jordibinefa/IoT-02/codes/wifi_mqtts_snap/IoT-02_mqtts_05_subButtonsPubOutputs.png

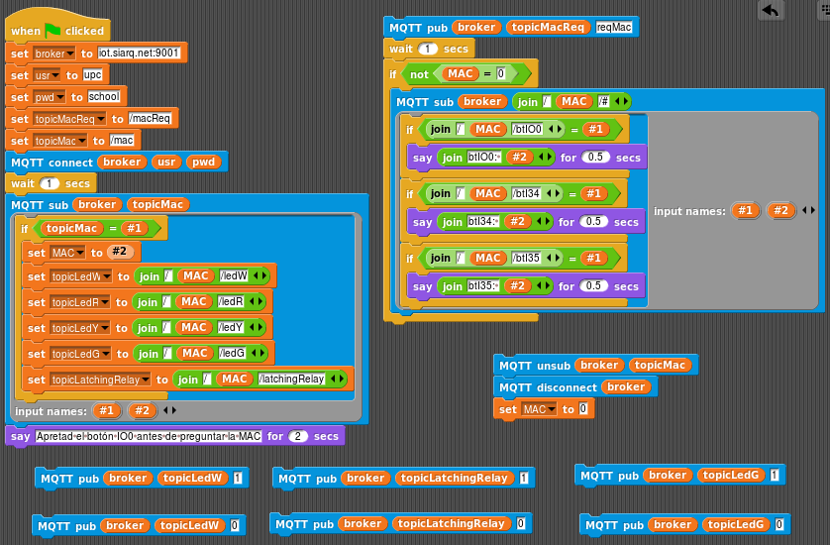
codes/wifi_mqtts_snap/IoT-02_mqtts_05_subButtonsPubOutputs.png
