jordibinefa/IoT-02/codes/wifi_mqtts_snap/IoT-02_mqtts_08_requestingTemperature.png

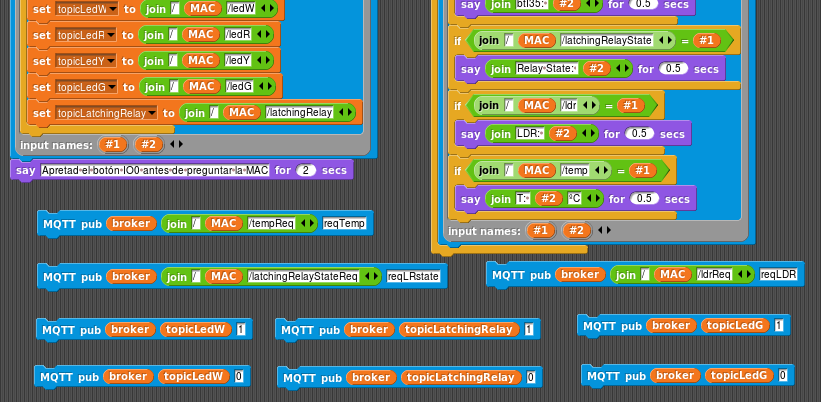
codes/wifi_mqtts_snap/IoT-02_mqtts_08_requestingTemperature.png
