jordibinefa/IoT-02/README.md

# IoT-02
Codes and schematics of IoT-02 board
