jordibinefa/IoT-02/iot02_00_en.pdf

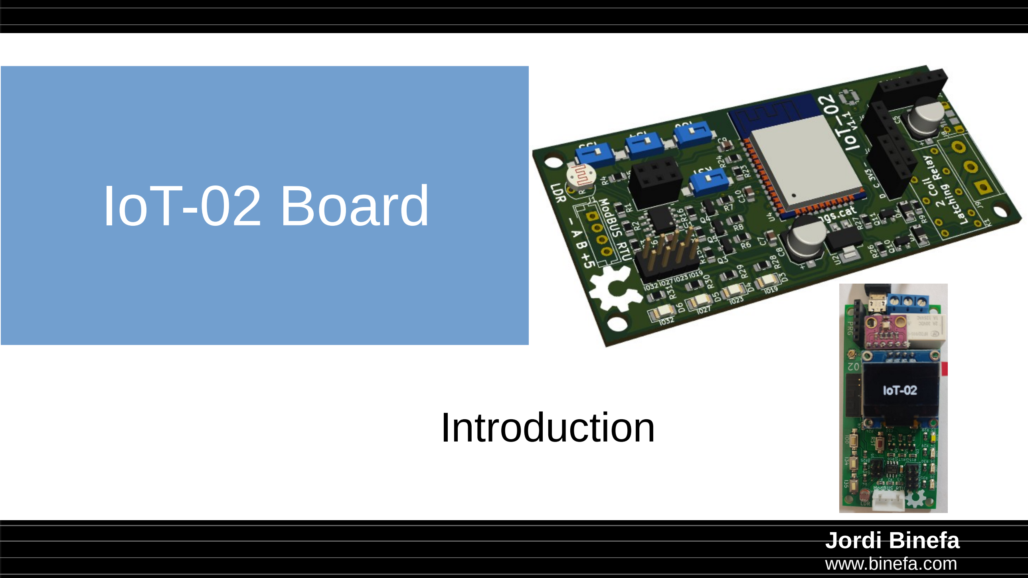
[picture p3: page 1]

## IoT-02 Board

Introduction

Jordi Binefa
www.binefa.com

IoT-02 Board ● Project repository ● Electronic schematic ● Key components ● Arduino IDE settings ● Firmware programming

www.binefa.com

## IoT-02 Board

- Project repository:
https://github.com/jordibinefa/IoT-02

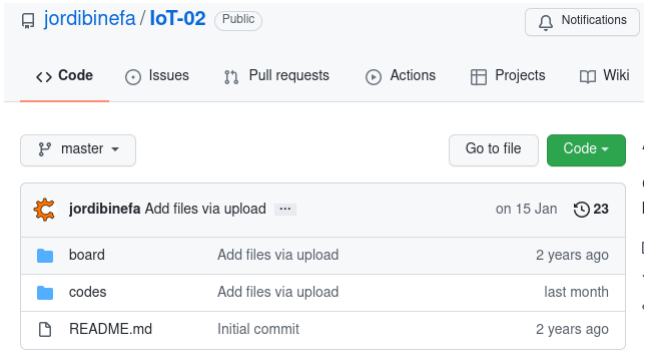
[picture p4: figure]

www.binefa.com

## IoT-02 Board

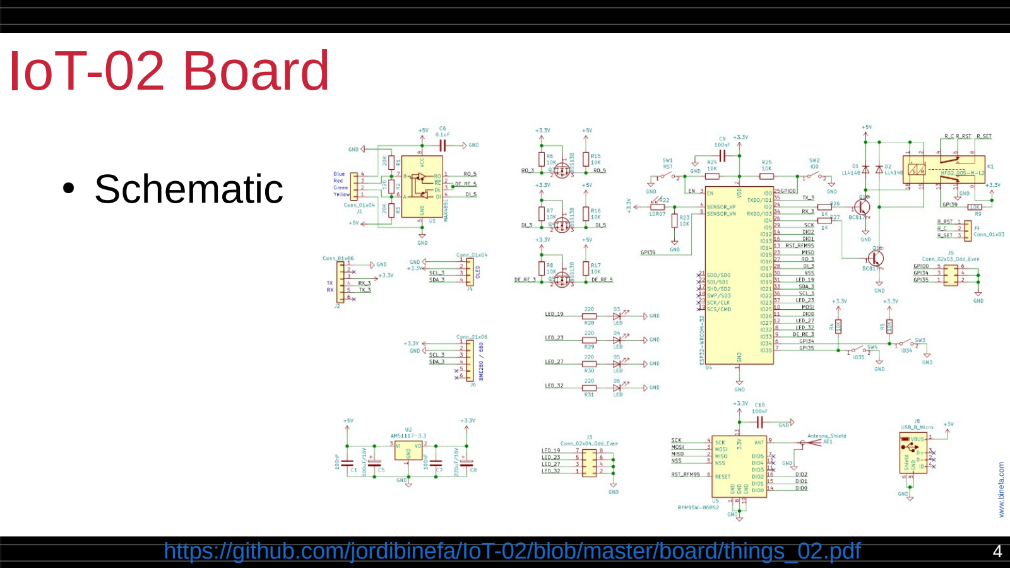
[picture p5: page 4]

- Schematic

https://github.com/jordibinefa/IoT-02/blob/master/board/things_02.pdf

www.binefa.com

IoT-02 Board ● CPU (ESP32) ● LDR ● Buttons ● Latching Relay

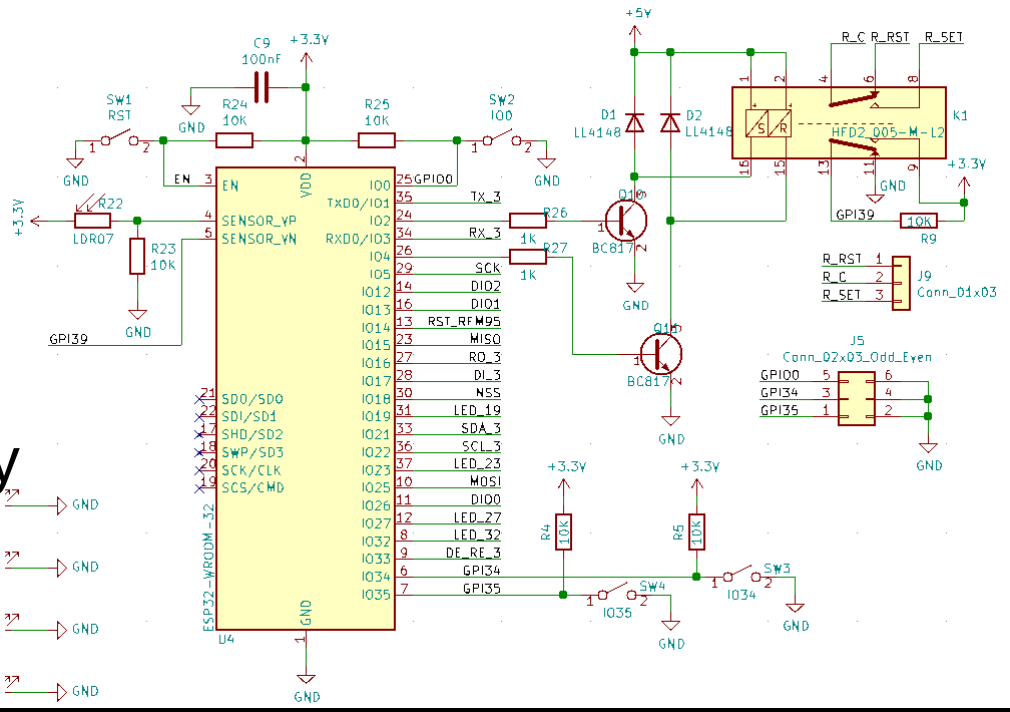
[picture p6: figure]

www.binefa.com

## IoT-02 Board

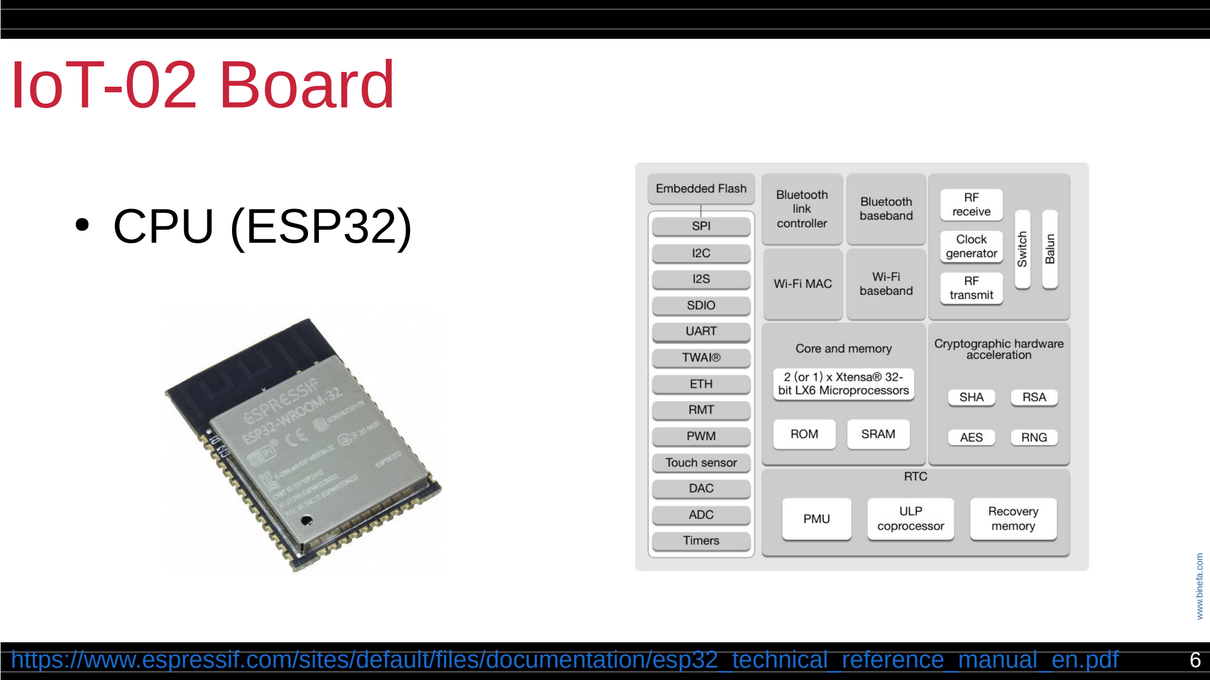
[picture p7: page 6]

- CPU (ESP32)

https://www.espressif.com/sites/default/files/documentation/esp32_technical_reference_manual_en.pdf

www.binefa.com

## IoT-02 Board

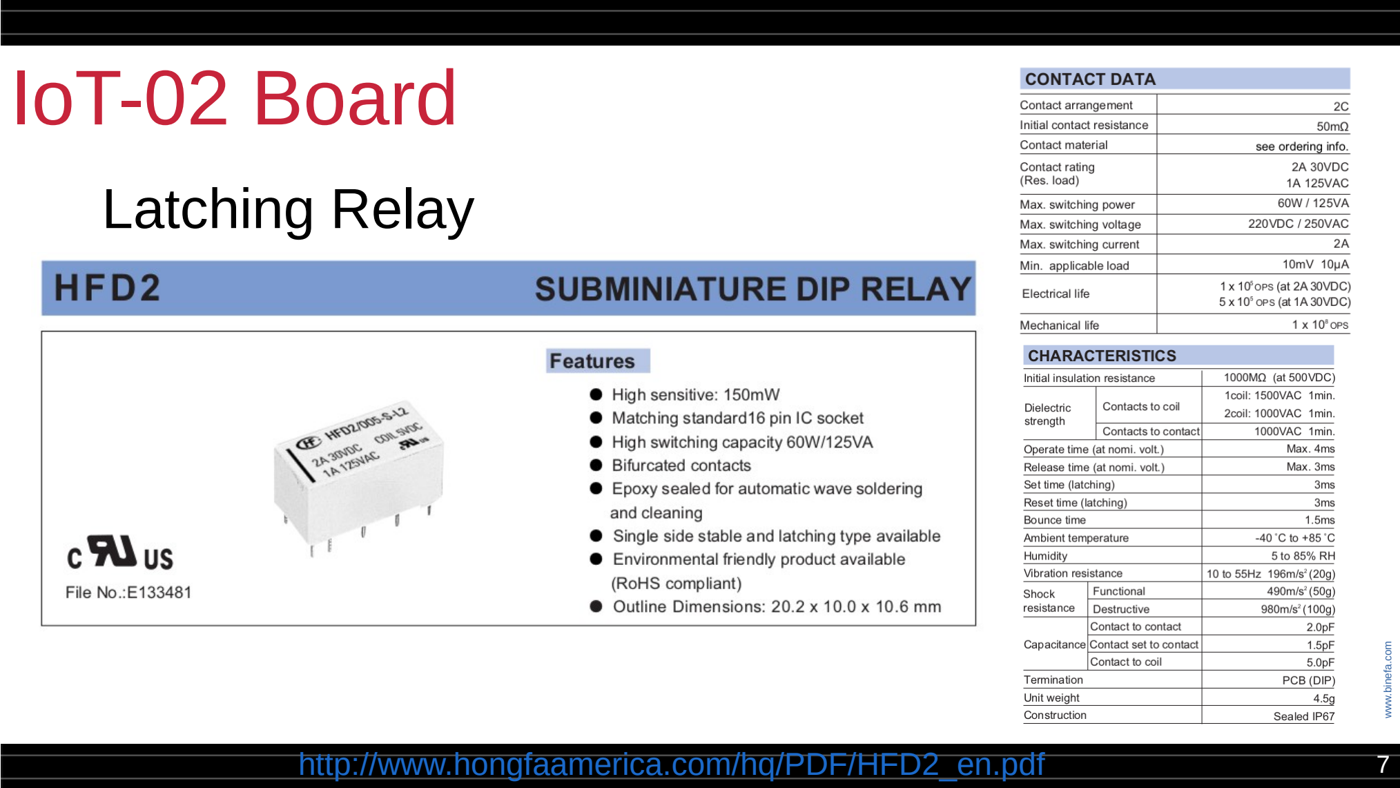
[picture p8: page 7]

Latching Relay

http://www.hongfaamerica.com/hq/PDF/HFD2_en.pdf

www.binefa.com

## IoT-02 Board

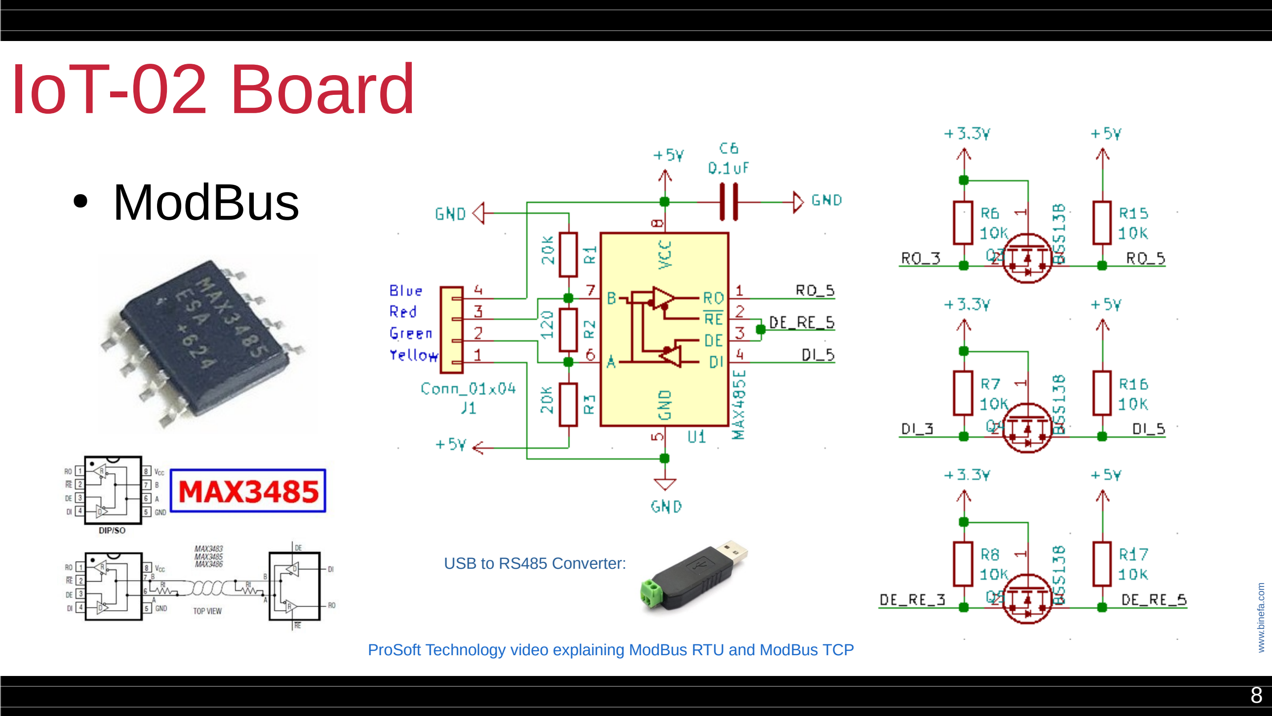
[picture p9: page 8]

- ModBus
ProSoft Technology video explaining ModBus RTU and ModBus TCP (https://youtu.be/k993tAFRLSE) | www.binefa.com

USB to RS485 Converter: (https://www.aliexpress.com/item/1005003395593541.html)

## IoT-02 Board

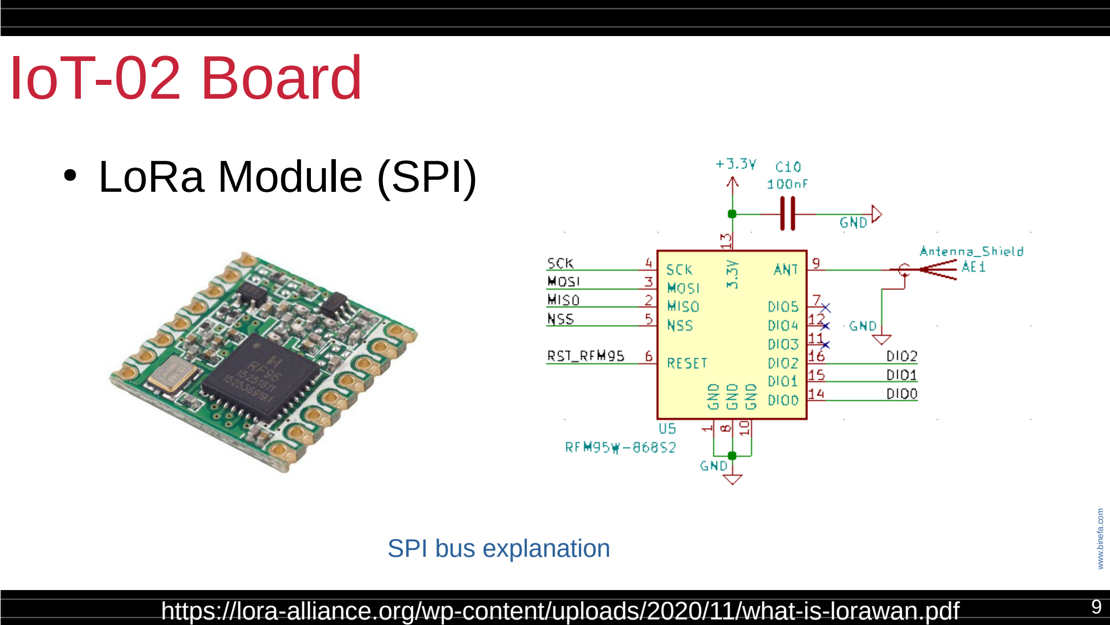
[picture p10: page 9]

- LoRa Module (SPI)

https://lora-alliance.org/wp-content/uploads/2020/11/what-is-lorawan.pdf

www.binefa.com
SPI bus explanation (https://www.luisllamas.es/arduino-spi/)

## IoT-02 Board

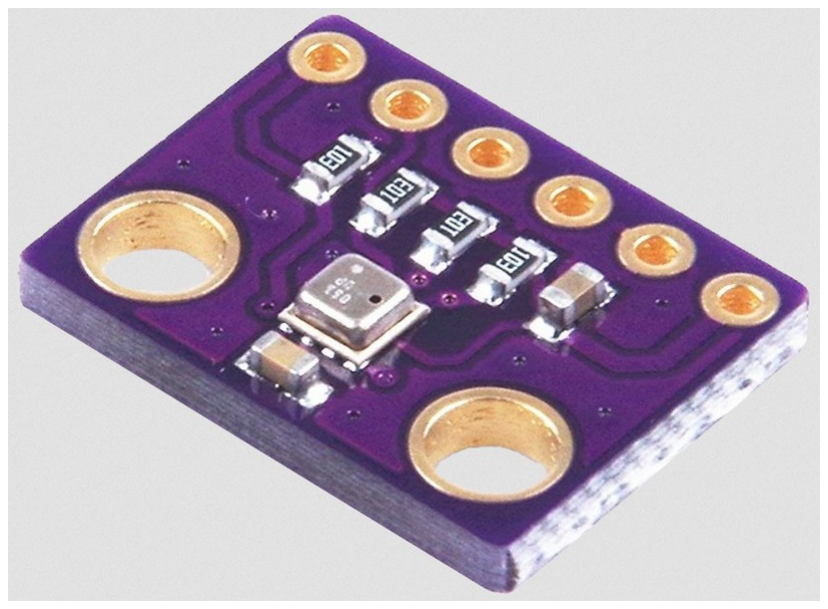
[picture p11: figure]

- I2C (BME280)

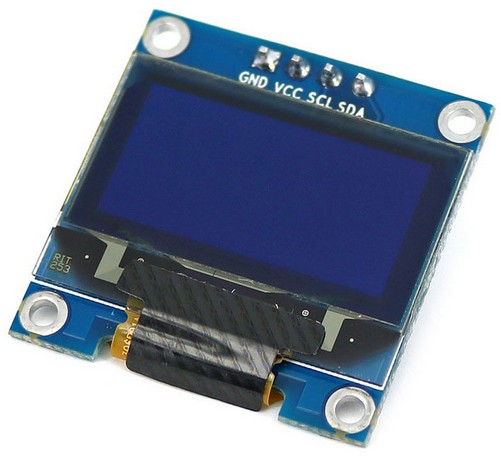
[picture p12: figure]

- I2C (OLED 0.96’’)

www.binefa.com
I2C bus explanation (https://www.luisllamas.es/arduino-i2c/)

## IoT-02 Board

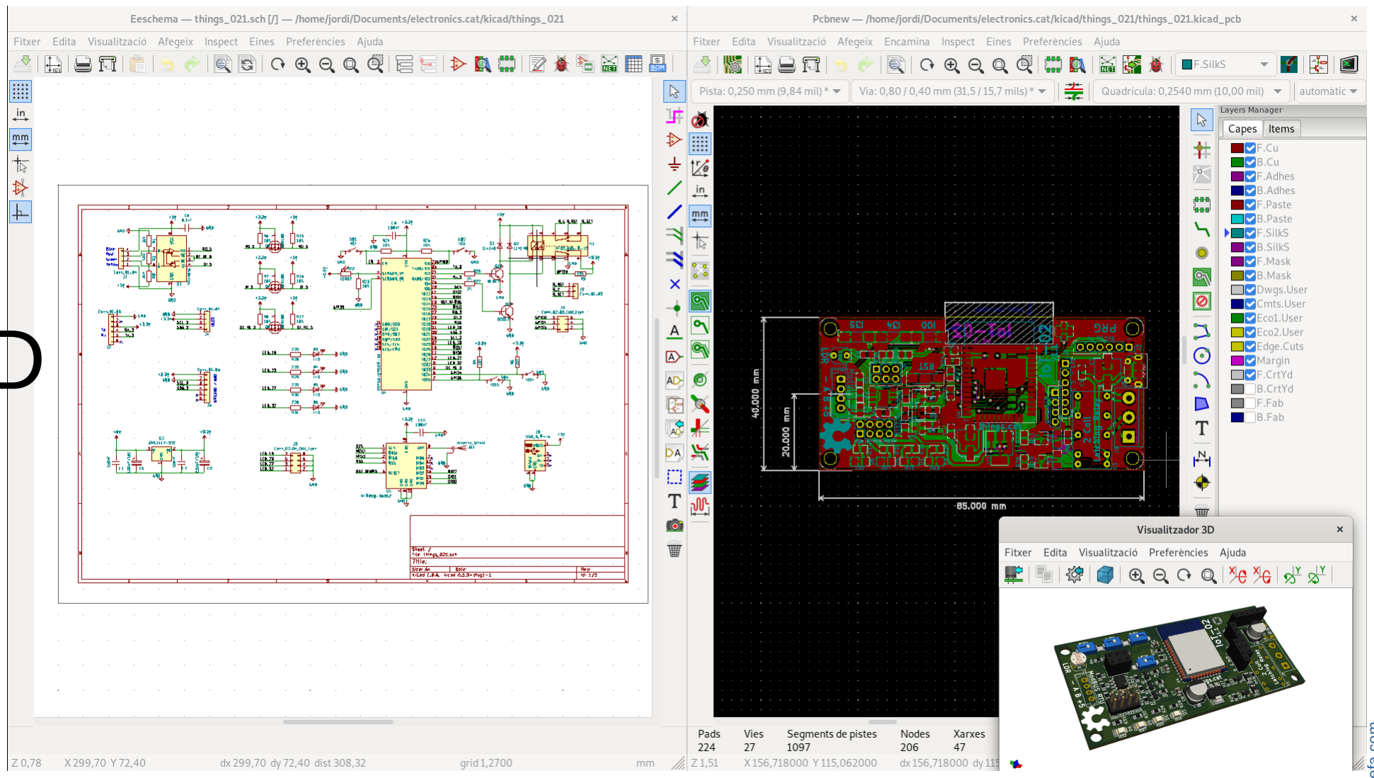
[picture p13: figure]

- Made with KiCAD

www.binefa.com

https://www.kicad.org/

## IoT-02 Board

Programmable with

- Arduino IDE
- Platform IO

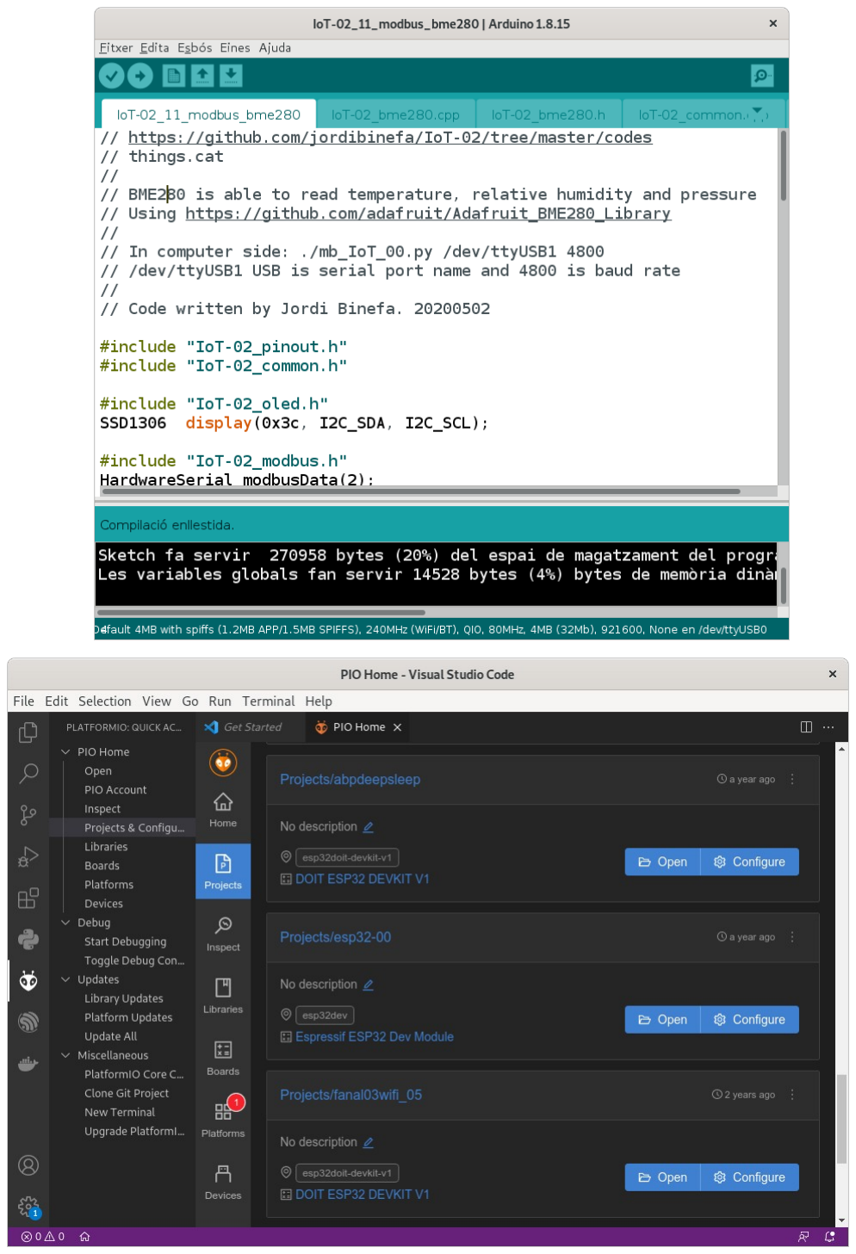
[picture p14: figure]

https://www.arduino.cc/ | https://platformio.org/

www.binefa.com

## IoT-02 Board

Installing ESP32 Add-on in Arduino IDE

www.binefa.com

- In your Arduino IDE, go to File / Preferences. Enter the following into the Additional Board Manager URLs :

https://dl.espressif.com/dl/package_esp32_index.json

- Open the Boards Manager. Go to Tools / Board: "..." / Boards Manager ... Search for ESP32 and press install button for the ESP32 by Espressif Systems . Approximately 300MB are automatically downloaded.
- Once it is installed, close the board installation popup. Select Tools / Board: "..." / ESP32 Dev Module. Select the Port at Tools / Port / /dev/ttyUSB0 (in Windows the port is COMx)

## IoT-02 Board

Arduino IDE libraries (493MB) (http://rebost.binefa.cat/iot/arduino/libraries_20220219.zip)

- These libraries are for compiling code examples (https://github.com/jordibinefa/IoT-02/tree/master/codes)

www.binefa.com

http://rebost.binefa.cat/iot/arduino/

Download all GitHub codes (https://github.com/jordibinefa/IoT-02/archive/refs/heads/master.zip) and Arduino IDE libraries (http://rebost.binefa.cat/iot/arduino/libraries_20220219.zip) on your computer. Libraries must be placed in the libraries directory inside Arduino folder ( /home/user in GNU / Linux and My Documents in Windows)

## IoT-02 Board

Sequence to select programming mode on IoT-02 board:

- Press the red button (RST)
- Press the IO0 white button
- Stop pressing the red button (RST)
- Stop pressing the IO0 white button

www.binefa.com

## IoT-02 Board

Uploading example firmware

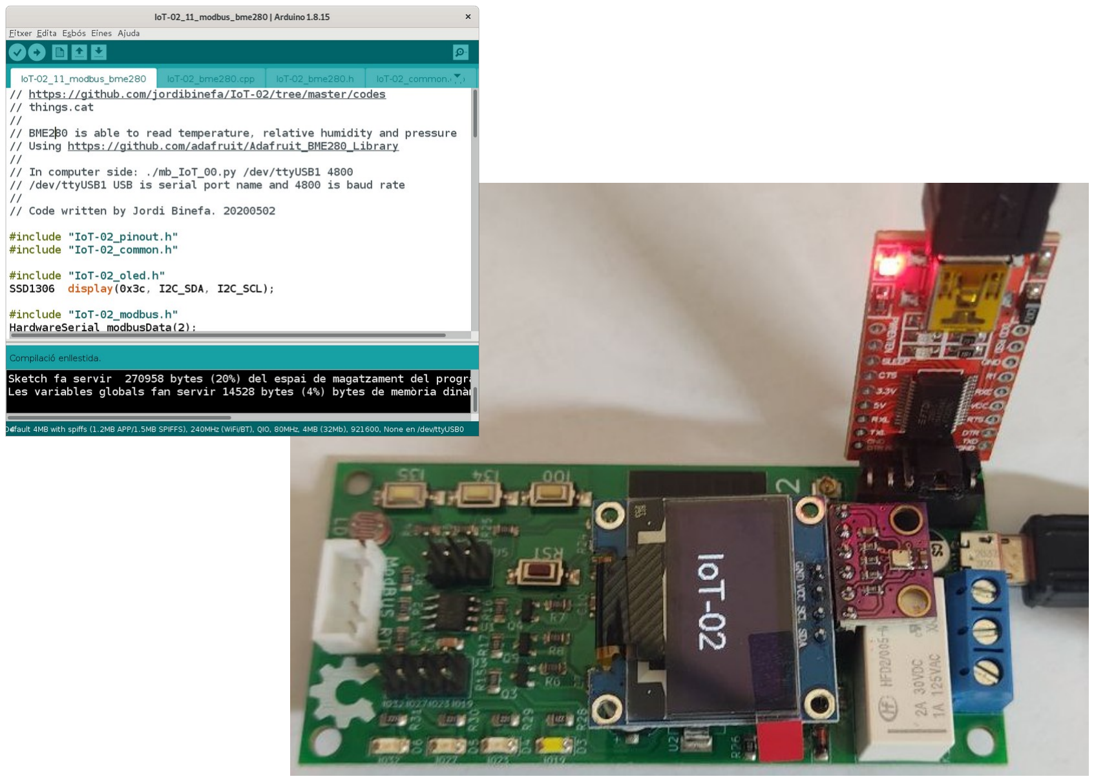
[picture p15: figure]

www.binefa.com

From Arduino IDE, open
IoT-02_07_SSD1306_BME280.ino (https://github.com/jordibinefa/IoT-02/tree/master/codes/IoT-02_07_SSD1306_BME280) file, previously downloaded with other example codes.

Set IoT-02 board in programming mode, connect the red board, and upload the firmware by pressing the round button with right pointing arrow ( )

## IoT-02 Board

Physical connection with other devices

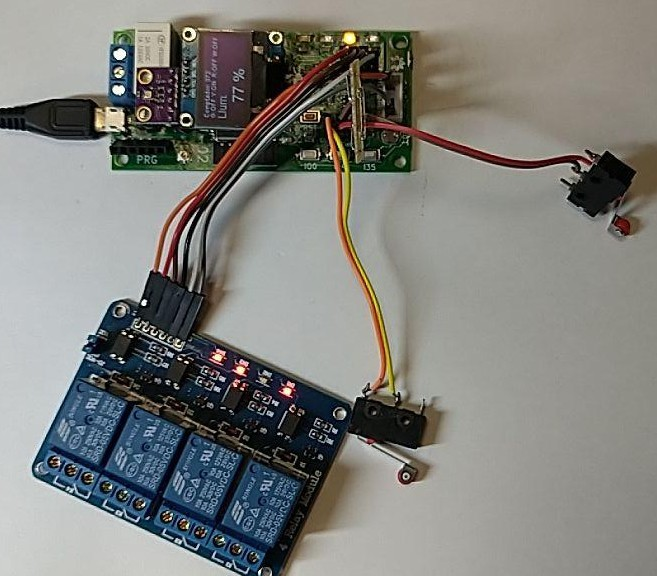
[picture p16: figure]

www.binefa.com

## IoT-02 Board

Practical Demonstration

www.binefa.com

## IoT-02 Board

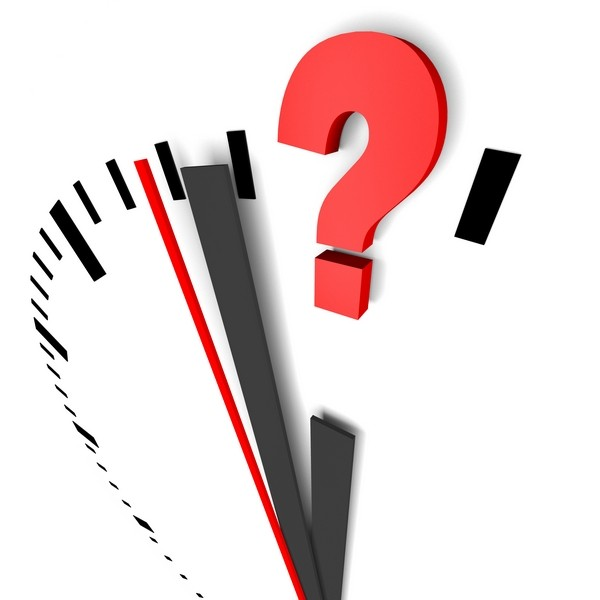
[picture p17: figure]

Question Time

www.binefa.com
