jordibinefa/IoT-02/iot02_00_ca.pdf

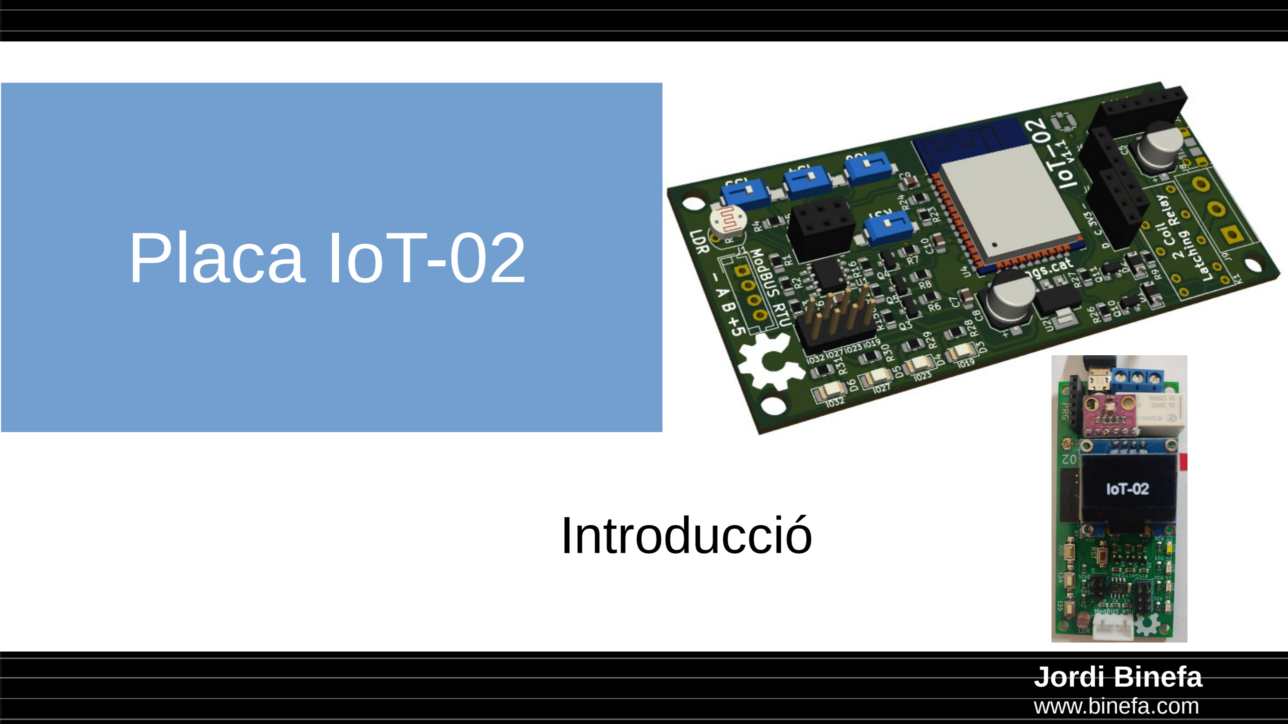
[picture p18: page 1]

# Placa IoT-02

# Introducció

Jordi Binefa
www.binefa.com

# Placa IoT-02

# - Repositori del projecte - Esquema electrònic - Components clau - Configuració de l’IDE d’Arduino - Programació del microprogramari

www.binefa.com

# Placa IoT-02

# - Repositori del projecte: https://github.com/jordibinefa/IoT-02


www.binefa.com

# Placa IoT-02

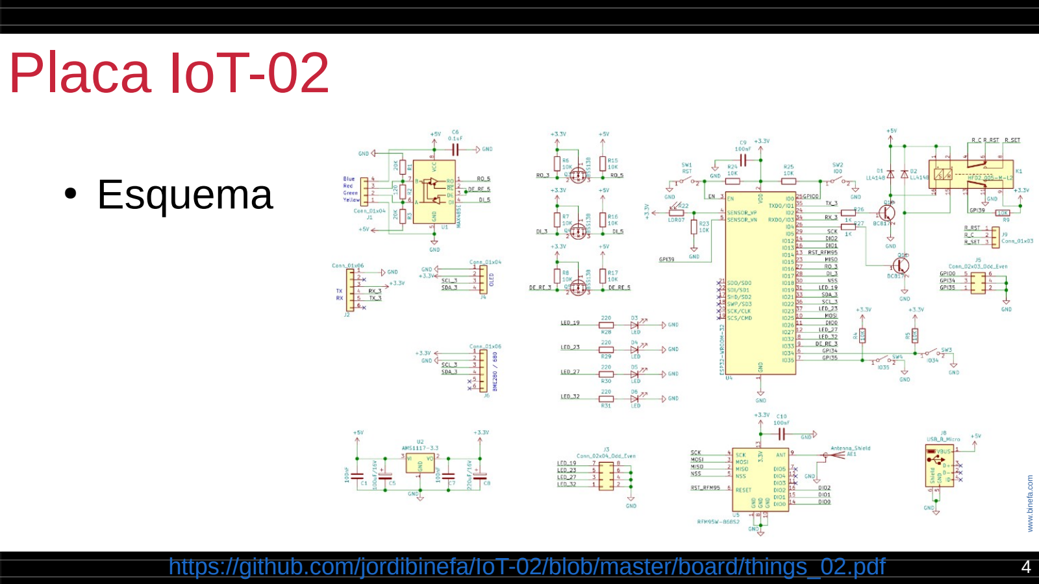
[picture p19: page 4]

# - Esquema

https://github.com/jordibinefa/IoT-02/blob/master/board/things_02.pdf

www.binefa.com

# Placa IoT-02 ● CPU (ESP32) ● LDR ● Botons ● Relé biestable

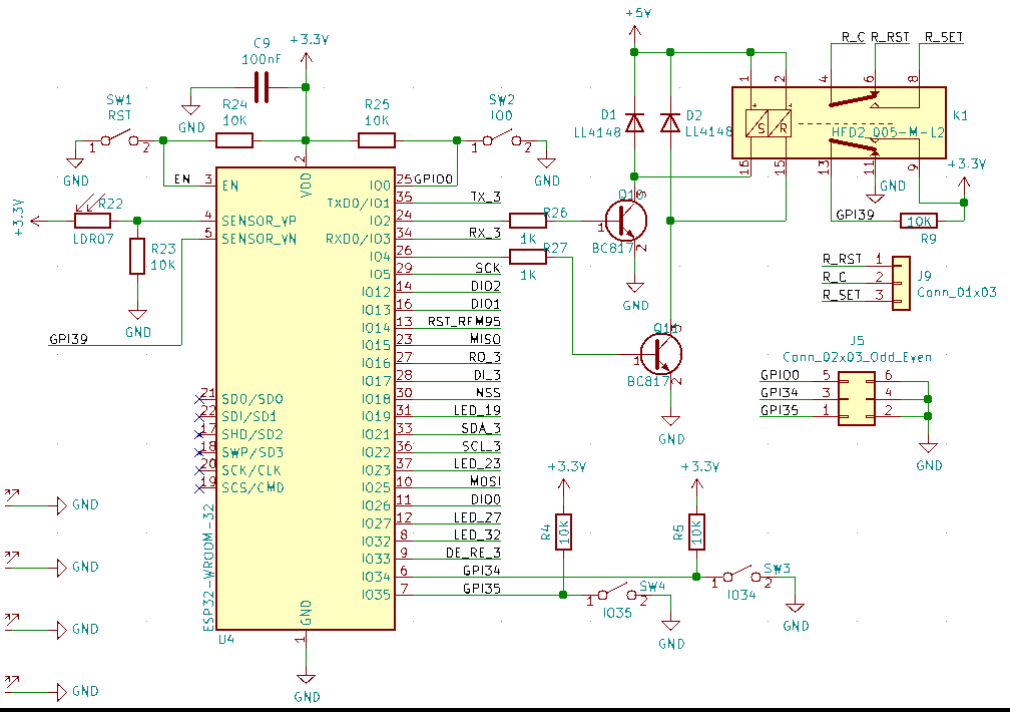
[picture p20: figure]

www.binefa.com

# Placa IoT-02

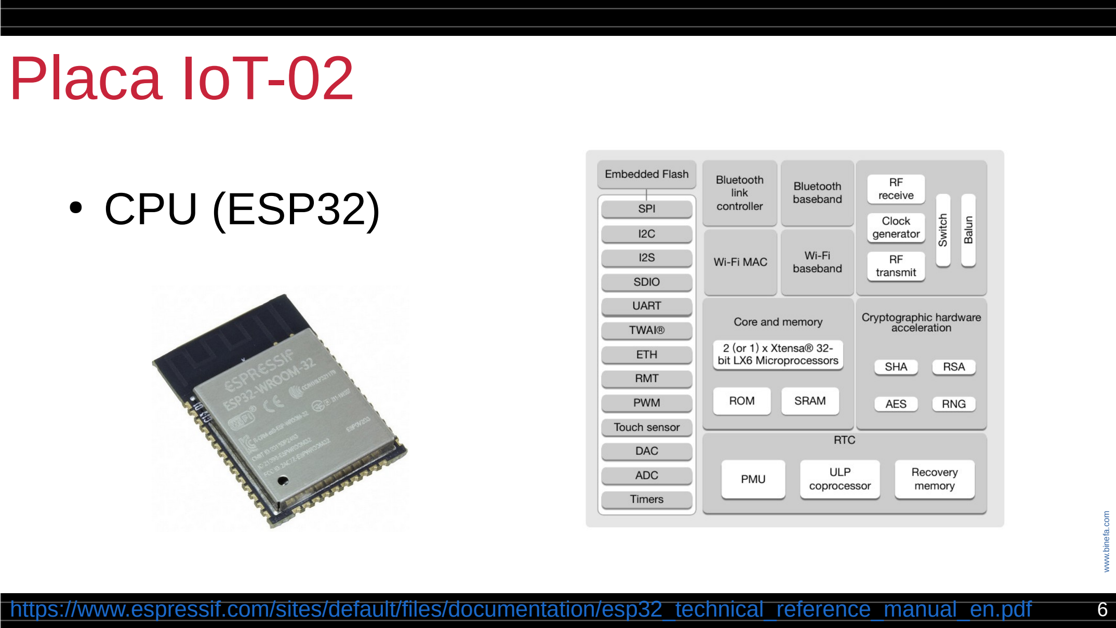
[picture p21: page 6]

# - CPU (ESP32)

https://www.espressif.com/sites/default/files/documentation/esp32_technical_reference_manual_en.pdf

www.binefa.com

# Placa IoT-02

# Relé biestable

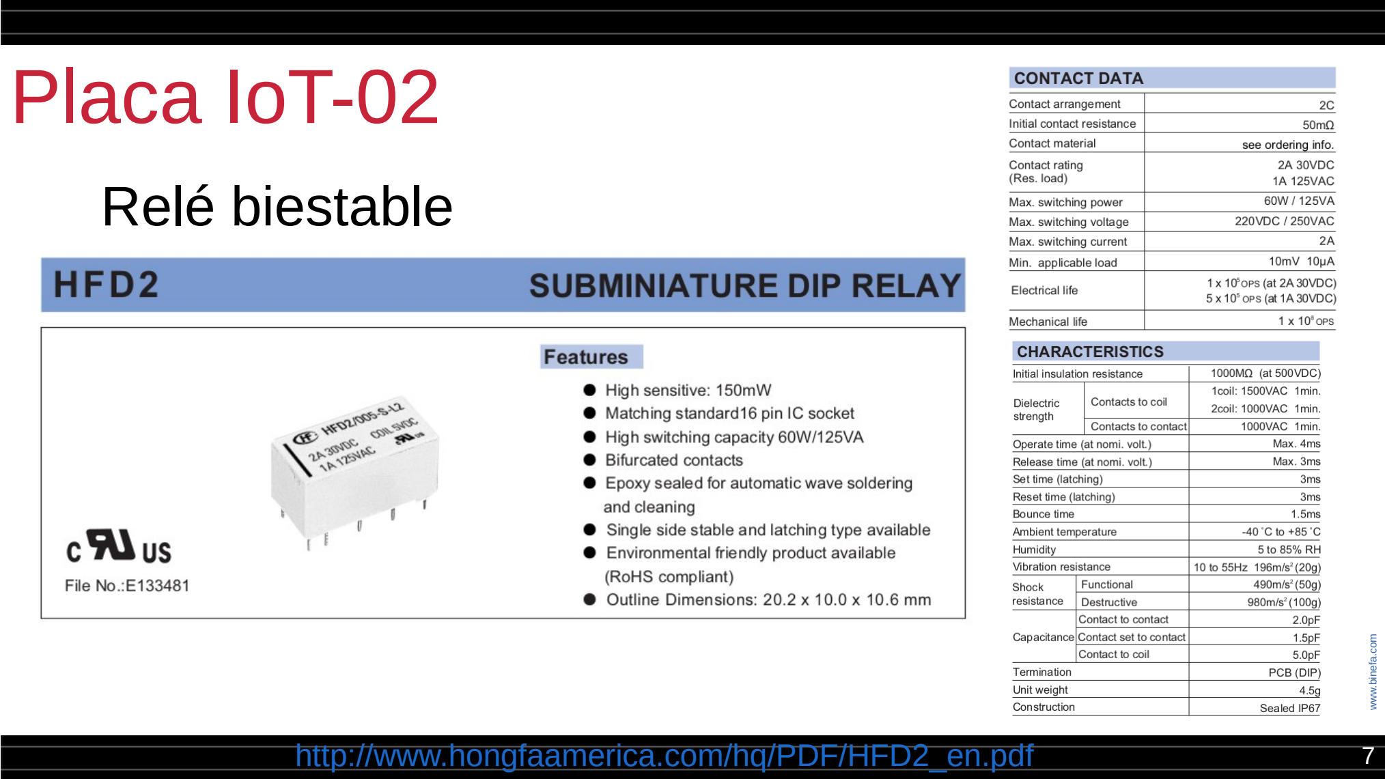
[picture p22: page 7]

http://www.hongfaamerica.com/hq/PDF/HFD2_en.pdf

www.binefa.com

# Placa IoT-02

# - ModBus

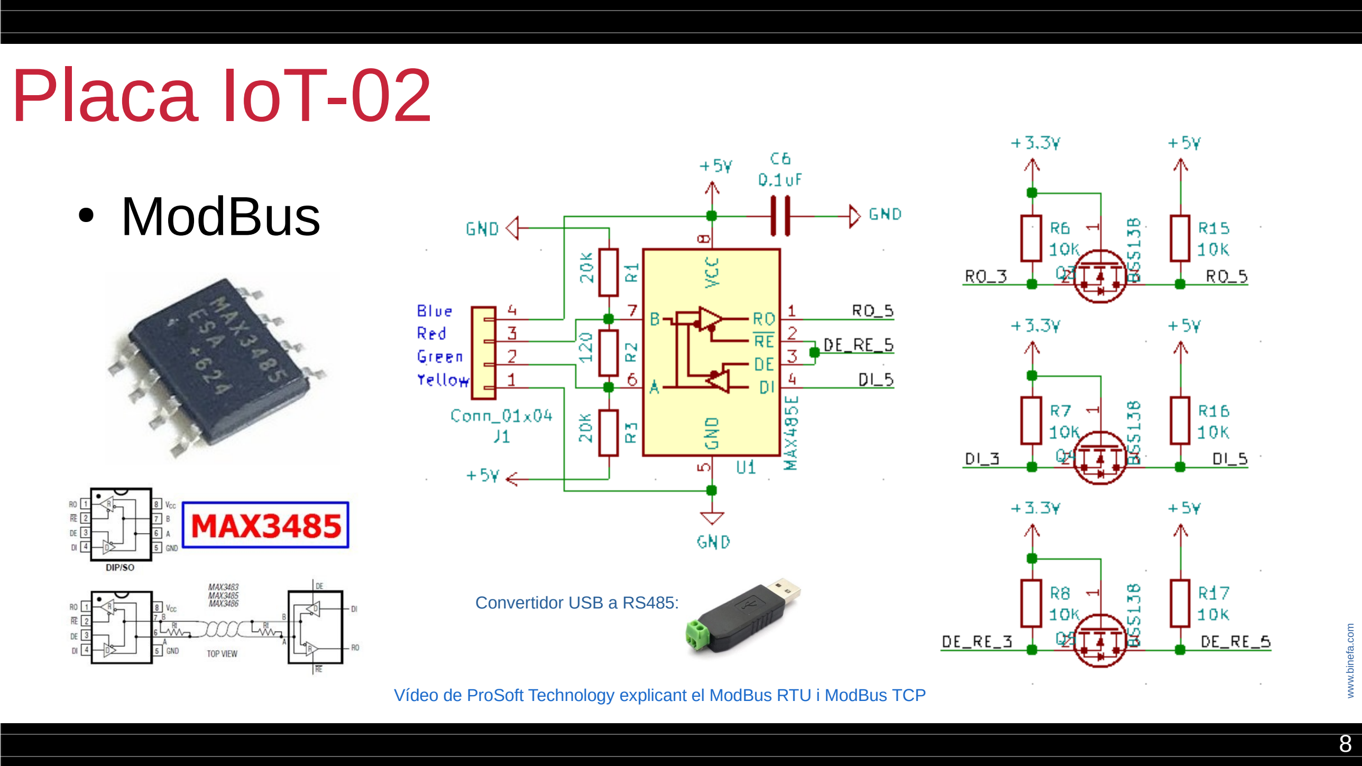
[picture p23: page 8]

Vídeo de ProSoft Technology explicant el ModBus RTU i ModBus TCP (https://youtu.be/k993tAFRLSE) | www.binefa.com

Convertidor USB a RS485: (https://www.aliexpress.com/item/1005003395593541.html)

# Placa IoT-02

# - Mòdul LoRa (SPI)

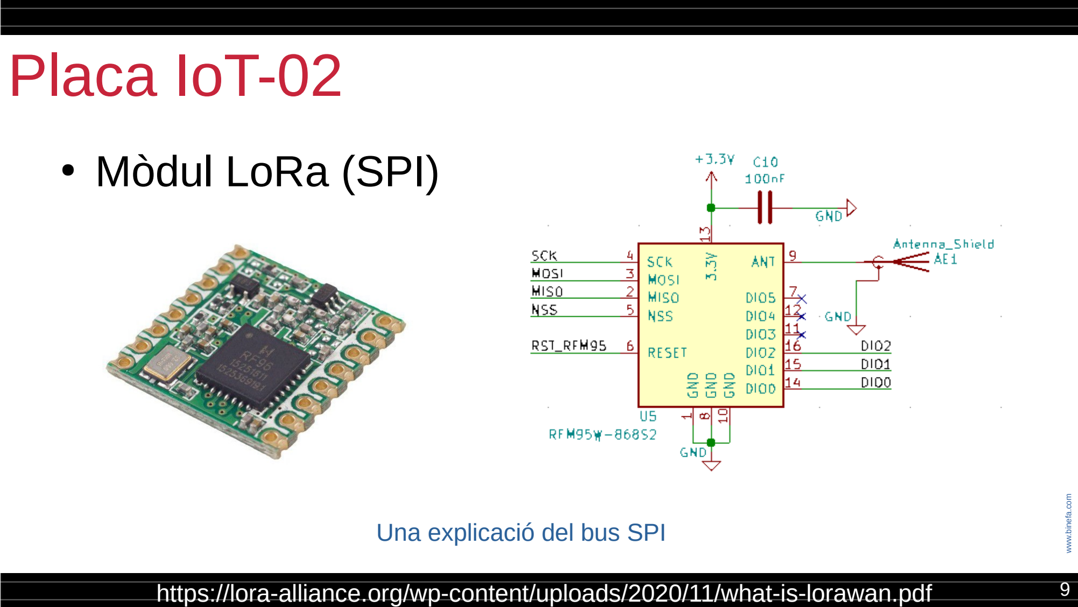
[picture p24: page 9]

https://lora-alliance.org/wp-content/uploads/2020/11/what-is-lorawan.pdf

www.binefa.com
Una explicació del bus SPI (https://www.luisllamas.es/arduino-spi/)

# Placa IoT-02


# - I2C (BME280)

# - I2C (OLED 0.96’’)

www.binefa.com

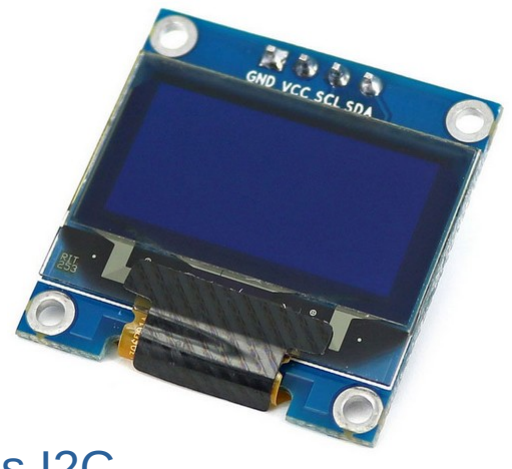
[picture p25: figure]

Una explicació del bus I2C (https://www.luisllamas.es/arduino-i2c/)

# Placa IoT-02

# - Fet amb KiCAD

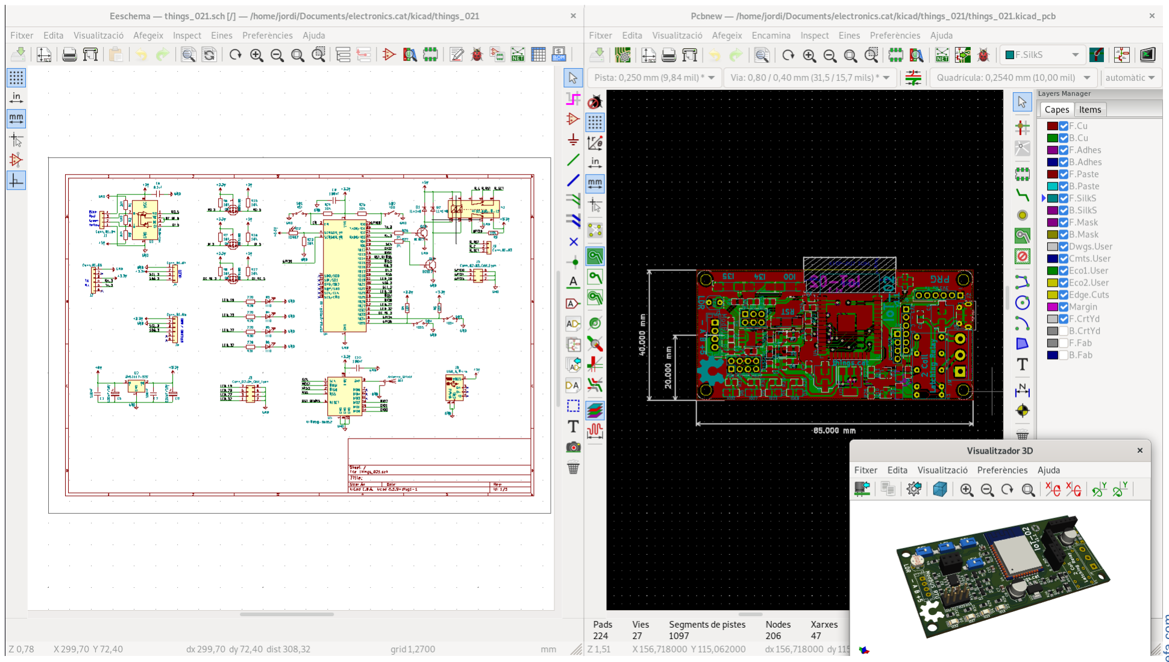
[picture p26: figure]

www.binefa.com

https://www.kicad.org/

# Placa IoT-02

# Programable amb

# - Arduino IDE

# - Platform IO


https://www.arduino.cc/ | https://platformio.org/

www.binefa.com

# Placa IoT-02

# Afegint l’ESP32 a l’IDE d’Arduino

www.binefa.com

- A l’IDE d’ Arduino aneu al menú i seleccioneu Fitxer / Preferències. Copieu a la casella indicada com URL addicionals del gestor de plaques :

https://dl.espressif.com/dl/package_esp32_index.json

- Al menú Eines / Placa: "..." / Gestor de plaques ... escriviu ESP32, seleccioneu esp32 by Espressif Systems i premeu el botó Instal·la. Aproximadament es baixen automàticament uns 300MB.
- Un cop instal·lat, tanqueu la finestra emergent de la instal·lació de la placa i seleccioneu Eines / Placa: "..." / ESP32 Dev Module. Després seleccioneu el port adient a Eines / Port / /dev/ttyUSB0 (a Windows el port és COMx)

# Placa IoT-02

Biblioteques per a l’Arduino IDE (493MB) (http://rebost.binefa.cat/iot/arduino/libraries_20220219.zip)

- Permeten compilar els exemples de codi (https://github.com/jordibinefa/IoT-02/tree/master/codes)

www.binefa.com

http://rebost.binefa.cat/iot/arduino/

Baixeu-vos al vostre ordinador tots els codis al GitHub (https://github.com/jordibinefa/IoT-02/archive/refs/heads/master.zip) i les biblioteques per a l’Arduino IDE. (http://rebost.binefa.cat/iot/arduino/libraries_20220219.zip) Les biblioteques les heu de posar al directori libraries que penja de la carpeta Arduino (present al directori base de l’usuari. /home/usuari a GNU / Linux i Els meus documents a Windows)

# Placa IoT-02

## Seqüència per passar a mode programació a la placa IoT-02:

## - Premeu el botó vermell (RST) - Premeu el botó blanc IO0 - Deixeu de prémer el botó vermell (RST) - Deixeu de prémer el botó blanc IO0

www.binefa.com

# Placa IoT-02

# Pujant un microprogramari d’exemple


www.binefa.com

Des de l’IDE d’Arduino obriu l’arxiu IoT-02_07_SSD1306_BME280.ino, (https://github.com/jordibinefa/IoT-02/tree/master/codes/IoT-02_07_SSD1306_BME280) baixat prèviament amb la resta de codis d’exemple.

Poseu la placa IoT-02 en mode programació, connecteu la placa vermella, i pugeu el microprogramari prement el botó rodó amb fletxa apuntant a la dreta ( )

# Placa IoT-02

# Connexió física amb altres dispositius


www.binefa.com

# Placa IoT-02

# Demostració pràctica

www.binefa.com

# Placa IoT-02

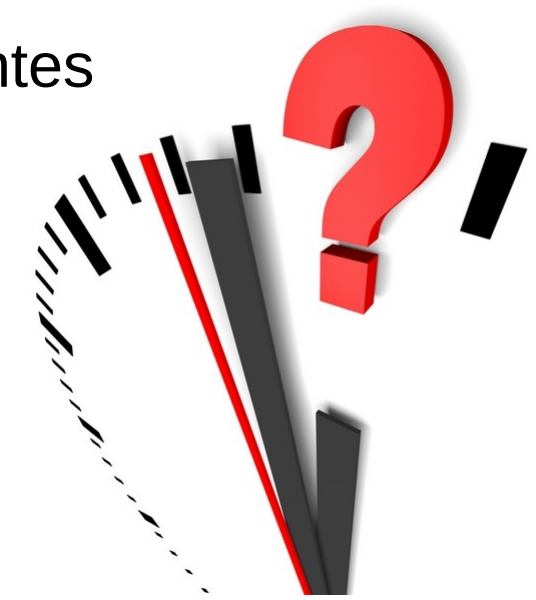
[picture p27: figure]

# Torn de preguntes

www.binefa.com
