jordibinefa/IoT-02/iot02_00_es.pdf

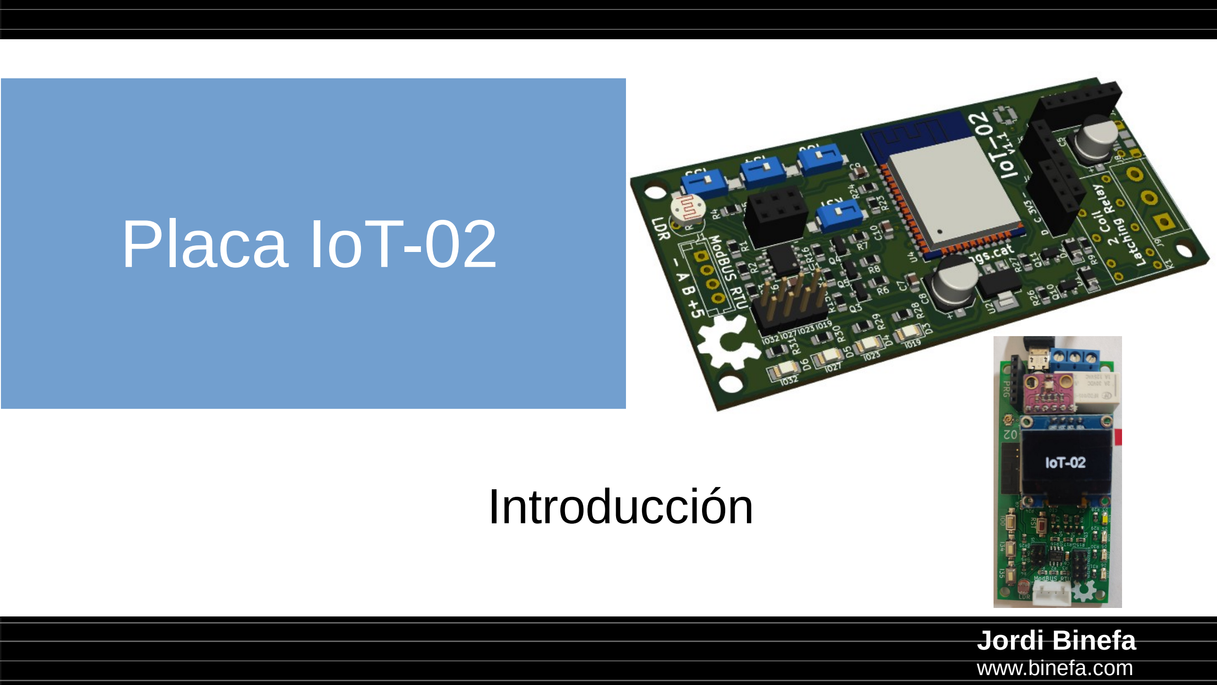
[picture p28: page 1]

# Placa IoT-02

# Introducción

Jordi Binefa
www.binefa.com

# Placa IoT-02

# - Repositorio del proyecto - Esquema electrónico - Components clave - Configuración del IDE de Arduino - Programación del firmware

www.binefa.com

# Placa IoT-02

# - Repositorio del proyecto: https://github.com/jordibinefa/IoT-02


www.binefa.com

# Placa IoT-02


# - Esquema

https://github.com/jordibinefa/IoT-02/blob/master/board/things_02.pdf

www.binefa.com

# Placa IoT-02 ● CPU (ESP32) ● LDR ● Botones ● Relé biestable


www.binefa.com

# Placa IoT-02


# - CPU (ESP32)

https://www.espressif.com/sites/default/files/documentation/esp32_technical_reference_manual_en.pdf

www.binefa.com

# Placa IoT-02

# Relé biestable


http://www.hongfaamerica.com/hq/PDF/HFD2_en.pdf

www.binefa.com

# Placa IoT-02

# - ModBus

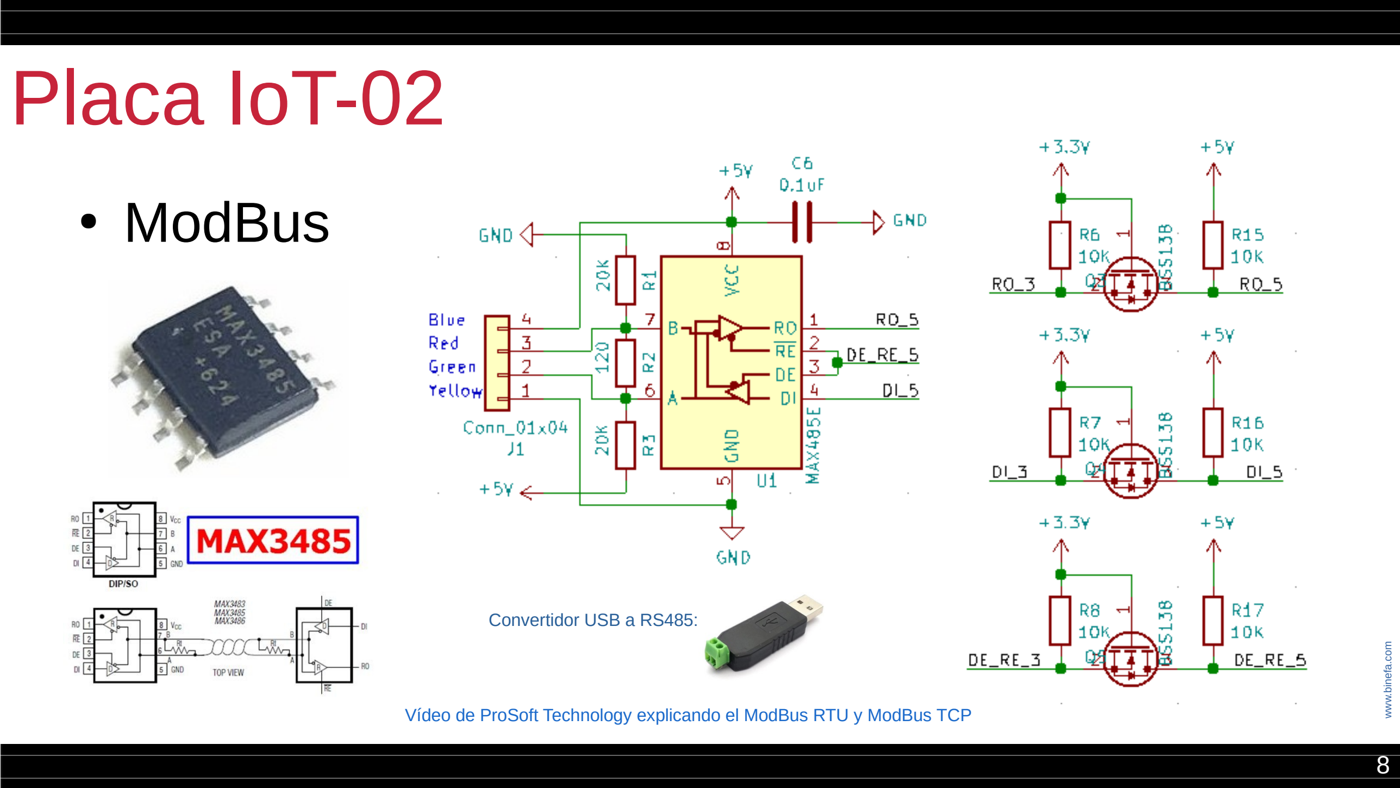
[picture p29: page 8]

Vídeo de ProSoft Technology explicando el ModBus RTU y ModBus TCP (https://youtu.be/k993tAFRLSE) | www.binefa.com

Convertidor USB a RS485: (https://www.aliexpress.com/item/1005003395593541.html)

# Placa IoT-02

# - Módulo LoRa (SPI)

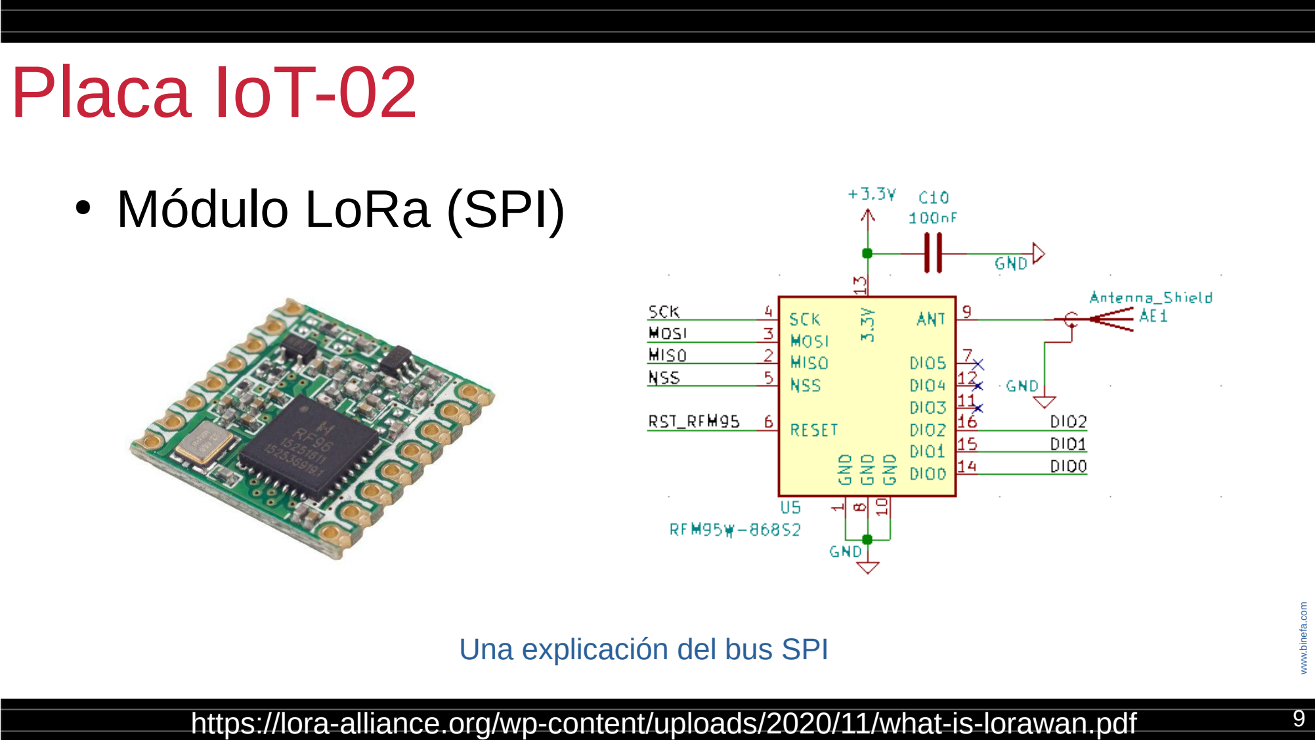
[picture p30: page 9]

https://lora-alliance.org/wp-content/uploads/2020/11/what-is-lorawan.pdf

www.binefa.com
Una explicación del bus SPI (https://www.luisllamas.es/arduino-spi/)

# Placa IoT-02


# - I2C (BME280)

# - I2C (OLED 0.96’’)

www.binefa.com

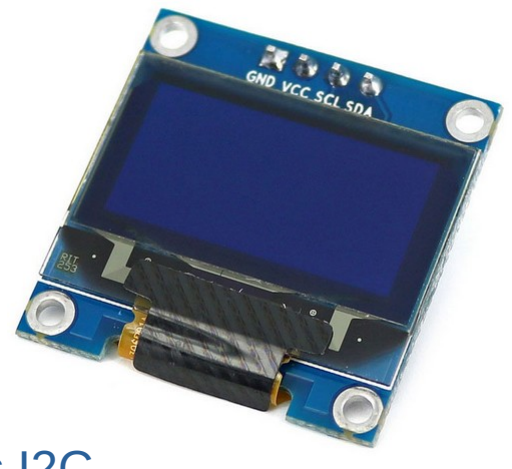
[picture p31: figure]

Una explicación del bus I2C (https://www.luisllamas.es/arduino-i2c/)

# Placa IoT-02

# - Hecho con KiCAD


www.binefa.com

https://www.kicad.org/

# Placa IoT-02

# Programable con

# - Arduino IDE

# - Platform IO


https://www.arduino.cc/ | https://platformio.org/

www.binefa.com

# Placa IoT-02

# Añadir ESP32 al IDE de Arduino

www.binefa.com

- En el IDE de Arduino ir al menú y seleccionar Fichero / Preferencias. Copiar en la casilla indicada como URLs adicionales del Gestor de placas:

https://dl.espressif.com/dl/package_esp32_index.json

- En el menú Herramientas / Placa: "..." / Gestor de placas escribir ESP32, seleccionar esp32 by Espressif Systems y clicar el botón Instalar. Aproximadamente se bajan automáticamente unos 300MB.
- Una vez instalado, cerrar la ventana emergente de instalación de la placa y seleccionar Herramientas / Placa: "..." / ESP32 Dev Module. Después seleccionar el puerto adecuado en Herramientas / Puerto / COMx (en GNU/Linux el puerto es /dev/ttyUSBx)

# Placa IoT-02

Bibliotecas para el IDE de Arduino (493MB) (http://rebost.binefa.cat/iot/arduino/libraries_20220219.zip)

- Permiten compilar los ejemplos de código (https://github.com/jordibinefa/IoT-02/tree/master/codes)

www.binefa.com

http://rebost.binefa.cat/iot/arduino/

Bajad al ordenador todos los códigos en el GitHub (https://github.com/jordibinefa/IoT-02/archive/refs/heads/master.zip) y las bibliotecas para el IDE de Arduino (http://rebost.binefa.cat/iot/arduino/libraries_20220219.zip) Las bibliotecas van al directorio libraries presente en la carpeta Arduino (que está en el directorio base del usuario. /home/usuario en GNU / Linux i Mis documentos en Windows)

●

# Placa IoT-02

## Secuencia para pasar a modo programación en la placa IoT-02:

## - Apretar el botón rojo (RST) - Apretar el botón blanco IO0 - Dejar de apretar el botón rojo (RST) - Dejar de apretar el botón blanco IO0

www.binefa.com

# Placa IoT-02

# Subiendo un firmware de ejemplo


www.binefa.com

Desde el IDE de Arduino abrid el archivo IoT-02_07_SSD1306_BME280.ino, (https://github.com/jordibinefa/IoT-02/tree/master/codes/IoT-02_07_SSD1306_BME280) bajado previamente con el resto de códigos de ejemplo.

Poned la placa IoT-02 en modo programación, conectad la placa roja, y subid el firmware apretando el botón redondo con flecha apuntando hacia la derecha ( )

# Placa IoT-02

# Conexión física con otros dispositivos


www.binefa.com

# Placa IoT-02

# Demostración práctica

www.binefa.com

# Placa IoT-02

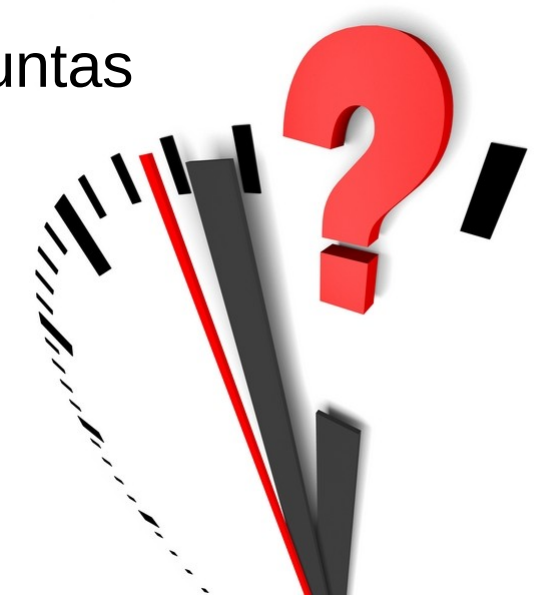
[picture p32: figure]

# Turno de preguntas

www.binefa.com
