jordibinefa/IoT-02/codes/binaryFirmware/IoT-02_Programmer.jpg

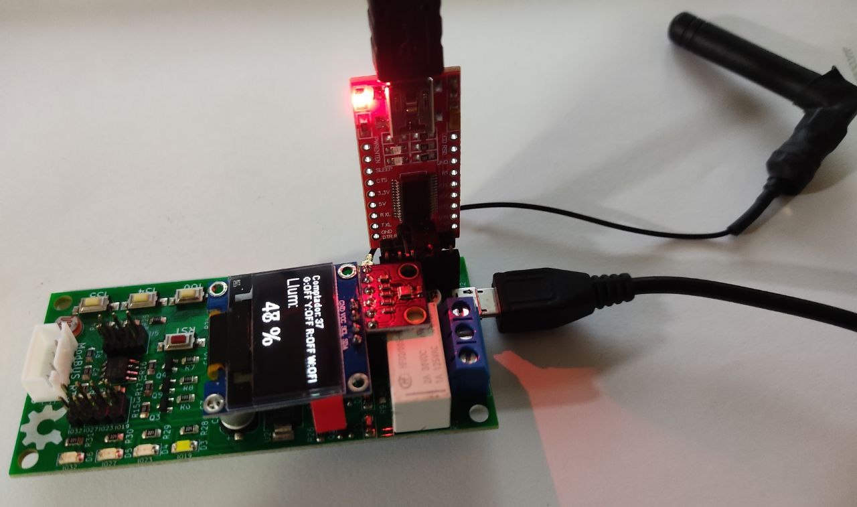
codes/binaryFirmware/IoT-02_Programmer.jpg
