jordibinefa/IoT-02/codes/binaryFirmware/Programming_IoT-02_screenshot.png

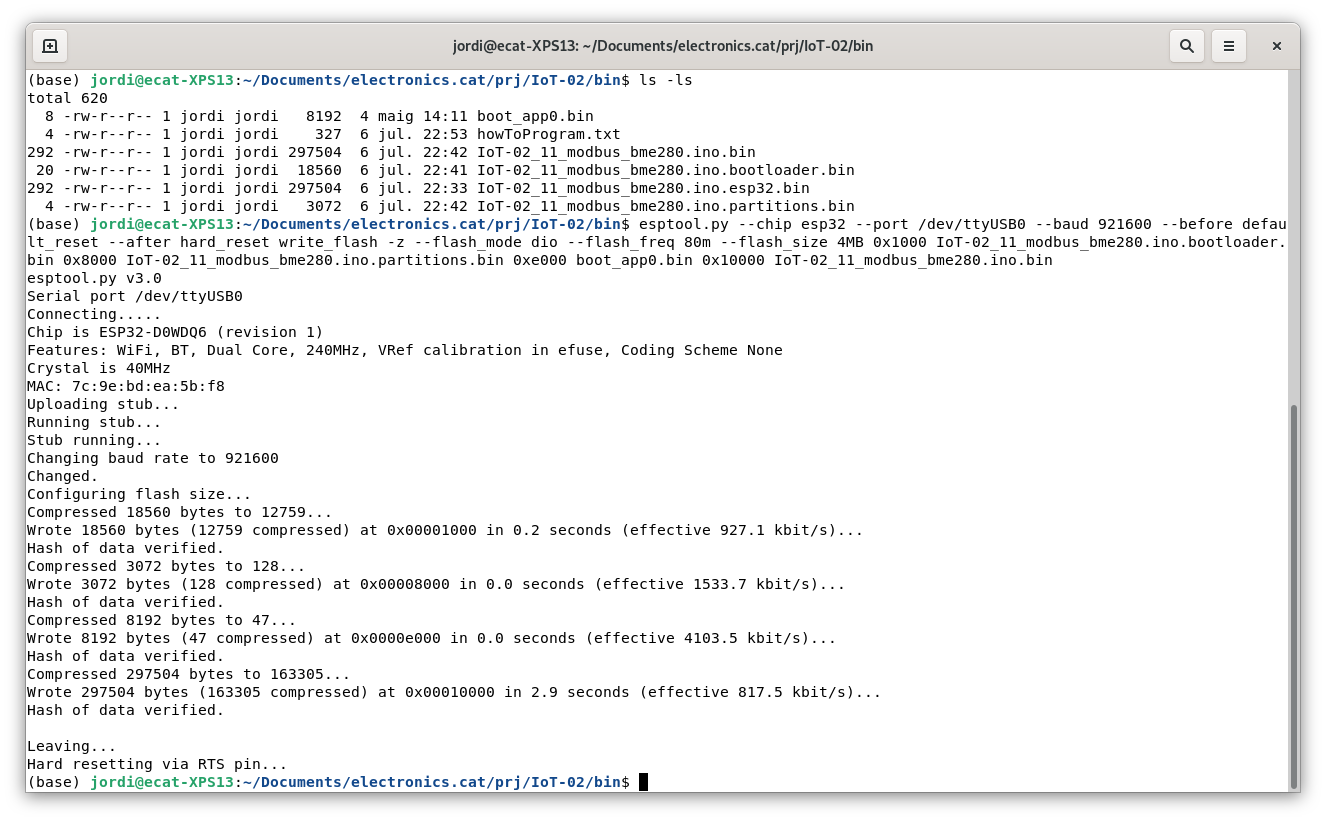
codes/binaryFirmware/Programming_IoT-02_screenshot.png
