jordibinefa/IoT-02/codes/wifi_basics/IoT-02_wifi_00_scan.png

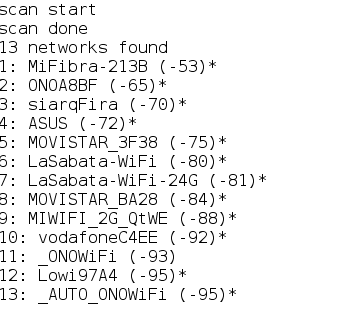
codes/wifi_basics/IoT-02_wifi_00_scan.png
