jordibinefa/IoT-02/codes/wifi_basics/IoT-02_wifi_03_multWiFi_wifiReset.png

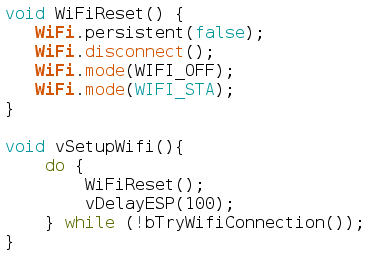
codes/wifi_basics/IoT-02_wifi_03_multWiFi_wifiReset.png
