jordibinefa/IoT-02/codes/wifi_mqtts_snap/IoT-02_mqtts_03_reqMac.png

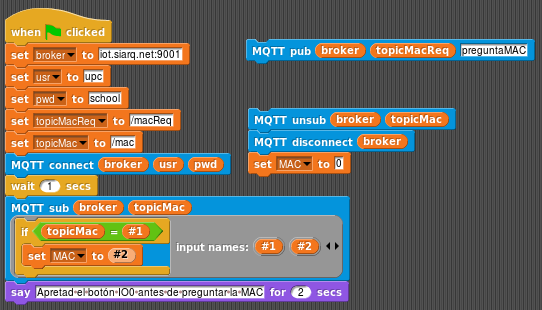
codes/wifi_mqtts_snap/IoT-02_mqtts_03_reqMac.png
