jordibinefa/IoT-02/codes/wifi_mqtts_snap/IoT-02_mqtts_04_ctrlOutputs.png

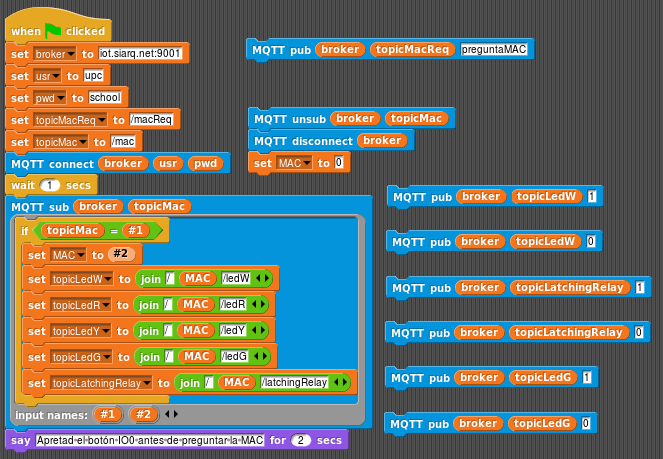
codes/wifi_mqtts_snap/IoT-02_mqtts_04_ctrlOutputs.png
