jordibinefa/IoT-02/codes/wifi_mqtts_snap/IoT-02_mqtts_06_requestingDigitalInput.png

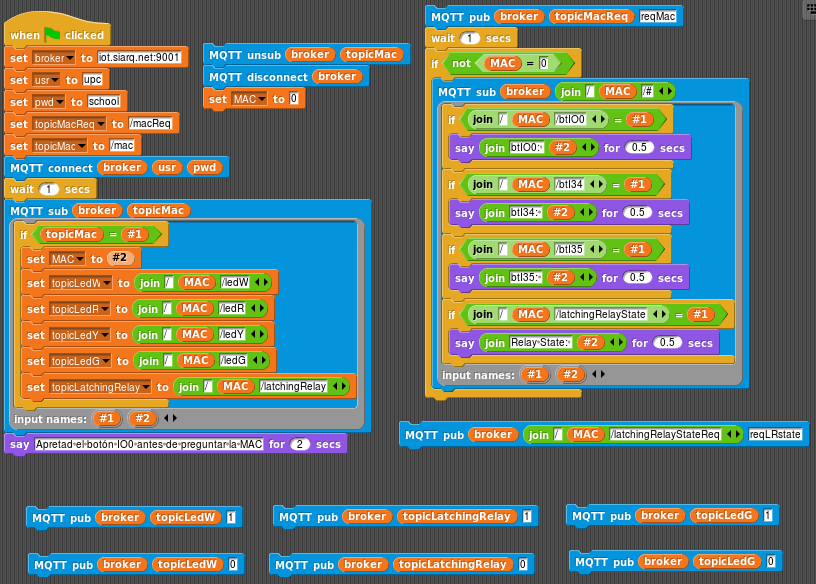
codes/wifi_mqtts_snap/IoT-02_mqtts_06_requestingDigitalInput.png
