jordibinefa/IoT-02/codes/wifi_mqtts_snap/IoT-02_mqtts_09_publishingOLED.png

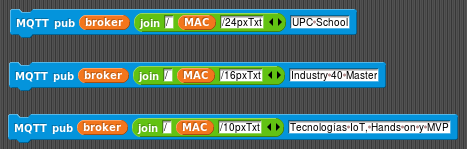
codes/wifi_mqtts_snap/IoT-02_mqtts_09_publishingOLED.png
