jordibinefa/IoT-02/codes/wifi_udp_nodeRed/IoT-02_wifi_04_udp_02.nodered.png

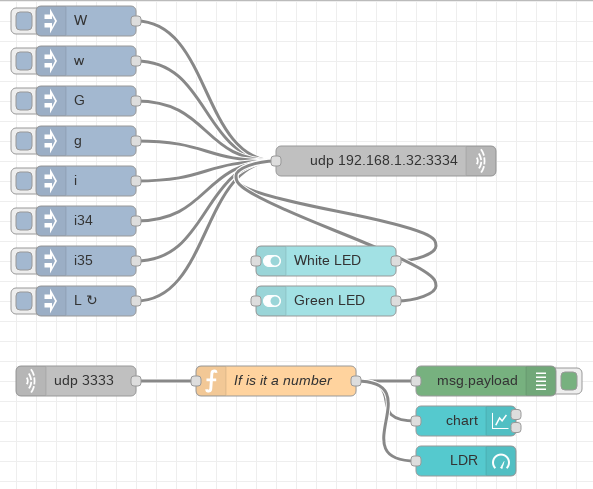
codes/wifi_udp_nodeRed/IoT-02_wifi_04_udp_02.nodered.png
