jordibinefa/IoT-02/codes/wifi_udp_nodeRed/IoT-02_wifi_04_udp_02.nodered_ui.png

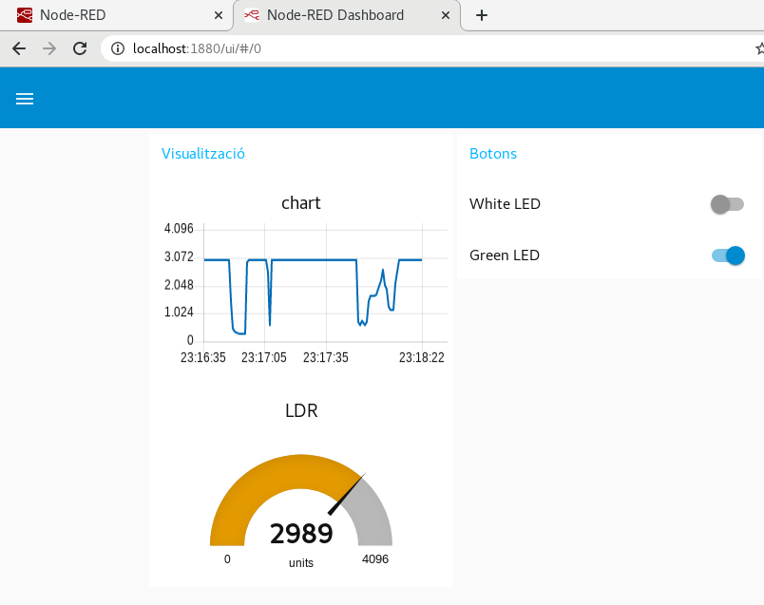
codes/wifi_udp_nodeRed/IoT-02_wifi_04_udp_02.nodered_ui.png
