jordibinefa/IoT-02/codes/wifi_webServer/IoT-02_wifi_01_simpleWiFiServer.png

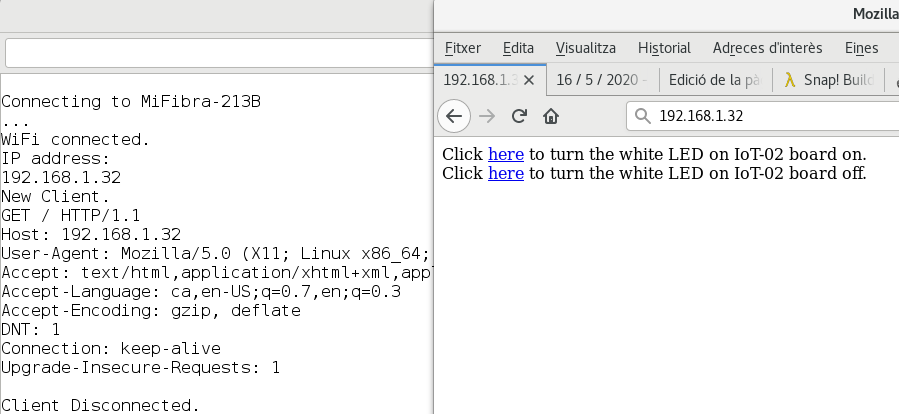
codes/wifi_webServer/IoT-02_wifi_01_simpleWiFiServer.png
