jordibinefa/IoT-02/board/kicad/things_02.csv

Reference | Value | Footprint | Datasheet
U4 | ESP32-WROOM-32 | RF_Module:ESP32-WROOM-32 | https://www.espressif.com/sites/default/files/documentation/esp32-wroom-32_datasheet_en.pdf
U2 | AMS1117-3.3 | Package_TO_SOT_SMD:SOT-223-3_TabPin2 | http://www.advanced-monolithic.com/pdf/ds1117.pdf
C5 | 100uF/16V | Capacitor_SMD:CP_Elec_5x5.9 | ~
C8 | 220uF/16V | Capacitor_SMD:CP_Elec_5x5.9 | ~
C1 | 100nF | Capacitor_SMD:C_1206_3216Metric | ~
C7 | 100nF | Capacitor_SMD:C_1206_3216Metric | ~
U1 | MAX485E | Package_SO:SOIC-8_3.9x4.9mm_P1.27mm | https://datasheets.maximintegrated.com/en/ds/MAX1487E-MAX491E.pdf
Q5 | BSS138 | Package_TO_SOT_SMD:SOT-23 | https://www.fairchildsemi.com/datasheets/BS/BSS138.pdf
R17 | 10K | Resistor_SMD:R_0805_2012Metric_Pad1.15x1.40mm_HandSolder | ~
R8 | 10K | Resistor_SMD:R_0805_2012Metric_Pad1.15x1.40mm_HandSolder | ~
Q3 | BSS138 | Package_TO_SOT_SMD:SOT-23 | https://www.fairchildsemi.com/datasheets/BS/BSS138.pdf
R15 | 10K | Resistor_SMD:R_0805_2012Metric_Pad1.15x1.40mm_HandSolder | ~
R6 | 10K | Resistor_SMD:R_0805_2012Metric_Pad1.15x1.40mm_HandSolder | ~
Q4 | BSS138 | Package_TO_SOT_SMD:SOT-23 | https://www.fairchildsemi.com/datasheets/BS/BSS138.pdf
R16 | 10K | Resistor_SMD:R_0805_2012Metric_Pad1.15x1.40mm_HandSolder | ~
R7 | 10K | Resistor_SMD:R_0805_2012Metric_Pad1.15x1.40mm_HandSolder | ~
C6 | 0.1uF | Capacitor_SMD:C_1206_3216Metric | ~
J1 | Conn_01x04 | Connector_JST:JST_EH_B04B-EH-A_1x04_P2.50mm_Vertical | ~
R1 | 20K | Resistor_SMD:R_0805_2012Metric_Pad1.15x1.40mm_HandSolder | ~
R3 | 20K | Resistor_SMD:R_0805_2012Metric_Pad1.15x1.40mm_HandSolder | ~
R2 | 120 | Resistor_SMD:R_0805_2012Metric_Pad1.15x1.40mm_HandSolder | ~
J2 | Conn_01x06 | Connector_PinSocket_2.54mm:PinSocket_1x06_P2.54mm_Vertical | ~
R24 | 10K | Resistor_SMD:R_0805_2012Metric_Pad1.15x1.40mm_HandSolder | ~
R25 | 10K | Resistor_SMD:R_0805_2012Metric_Pad1.15x1.40mm_HandSolder | ~
C9 | 100nF | Capacitor_SMD:C_1206_3216Metric | ~
R29 | 220 | Resistor_SMD:R_0805_2012Metric_Pad1.15x1.40mm_HandSolder | ~
D4 | LED | LED_SMD:LED_1206_3216Metric_Pad1.42x1.75mm_HandSolder | ~
J4 | Conn_01x04 | Connector_PinSocket_2.54mm:PinSocket_1x04_P2.54mm_Vertical | ~
J6 | Conn_01x06 | Connector_PinSocket_2.54mm:PinSocket_1x06_P2.54mm_Vertical | ~
U5 | RFM95W-868S2 | RF_Module:HOPERF_RFM9XW_SMD | http://www.hoperf.com/upload/rf/RFM95_96_97_98W.pdf
C10 | 100nF | Capacitor_SMD:C_1206_3216Metric | ~
AE1 | Antenna_Shield | Connector_Coaxial:U.FL_Molex_MCRF_73412-0110_Vertical | ~
SW1 | RST | Button_Switch_SMD:SW_SPST_EVQPE1
SW2 | IO0 | Button_Switch_SMD:SW_SPST_EVQPE1
SW3 | IO34 | Button_Switch_SMD:SW_SPST_EVQPE1
R22 | LDR07 | OptoDevice:R_LDR_5.1x4.3mm_P3.4mm_Vertical | http://www.tme.eu/de/Document/f2e3ad76a925811312d226c31da4cd7e/LDR07.pdf
R23 | 10K | Resistor_SMD:R_0805_2012Metric_Pad1.15x1.40mm_HandSolder | ~
SW4 | IO35 | Button_Switch_SMD:SW_SPST_EVQPE1
R28 | 220 | Resistor_SMD:R_0805_2012Metric_Pad1.15x1.40mm_HandSolder | ~
D3 | LED | LED_SMD:LED_1206_3216Metric_Pad1.42x1.75mm_HandSolder | ~
R26 | 1K | Resistor_SMD:R_0805_2012Metric_Pad1.15x1.40mm_HandSolder | ~
R27 | 1K | Resistor_SMD:R_0805_2012Metric_Pad1.15x1.40mm_HandSolder | ~
Q11 | BC817 | Package_TO_SOT_SMD:SOT-23 | http://www.fairchildsemi.com/ds/BC/BC817.pdf
Q10 | BC817 | Package_TO_SOT_SMD:SOT-23 | http://www.fairchildsemi.com/ds/BC/BC817.pdf
D1 | LL4148 | Diode_SMD:D_1206_3216Metric_Pad1.42x1.75mm_HandSolder | ~
D2 | LL4148 | Diode_SMD:D_1206_3216Metric_Pad1.42x1.75mm_HandSolder | ~
J9 | Conn_01x03 | TerminalBlock:TerminalBlock_bornier-3_P5.08mm | ~
K1 | HFD2_005-M-L2 | Relay_THT:HFD2_005-M-L2 | http://www.azettler.com/pdfs/az850.pdf
J8 | USB_B_Micro | Connector_USB:USB_Micro-B_Amphenol_10103594-0001LF_Horizontal | ~
R31 | 220 | Resistor_SMD:R_0805_2012Metric_Pad1.15x1.40mm_HandSolder | ~
D6 | LED | LED_SMD:LED_1206_3216Metric_Pad1.42x1.75mm_HandSolder | ~
R30 | 220 | Resistor_SMD:R_0805_2012Metric_Pad1.15x1.40mm_HandSolder | ~
D5 | LED | LED_SMD:LED_1206_3216Metric_Pad1.42x1.75mm_HandSolder | ~
R4 | 10K | Resistor_SMD:R_0805_2012Metric_Pad1.15x1.40mm_HandSolder | ~
R5 | 10K | Resistor_SMD:R_0805_2012Metric_Pad1.15x1.40mm_HandSolder | ~
R9 | 10K | Resistor_SMD:R_0805_2012Metric_Pad1.15x1.40mm_HandSolder | ~
J5 | Conn_02x03_Odd_Even | Connector_PinSocket_2.54mm:PinSocket_2x03_P2.54mm_Vertical | ~
J3 | Conn_02x04_Odd_Even | Connector_PinHeader_2.54mm:PinHeader_2x04_P2.54mm_Vertical | ~
