jordibinefa/IoT-02/board/pdf/things_02-PTH-drl_map.dxf

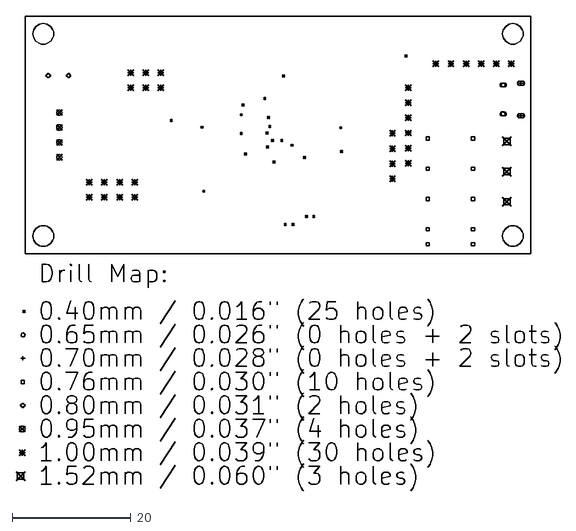
[picture p46: CAD file, 2020-03-15]
board/pdf/things_02-PTH-drl_map.dxf
91.5 x 79.9
