jordibinefa/IoT-02/board/pdf/things_02-NPTH-drl_map.dxf

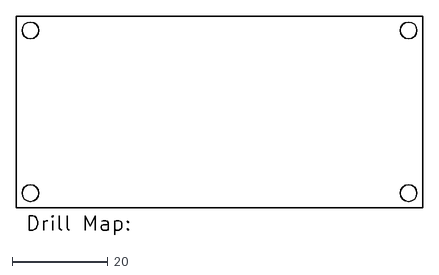
[picture p47: CAD file, 2020-03-15]
board/pdf/things_02-NPTH-drl_map.dxf
85.0 x 45.7
