jordibinefa/IoT-02/board/things_02.pdf

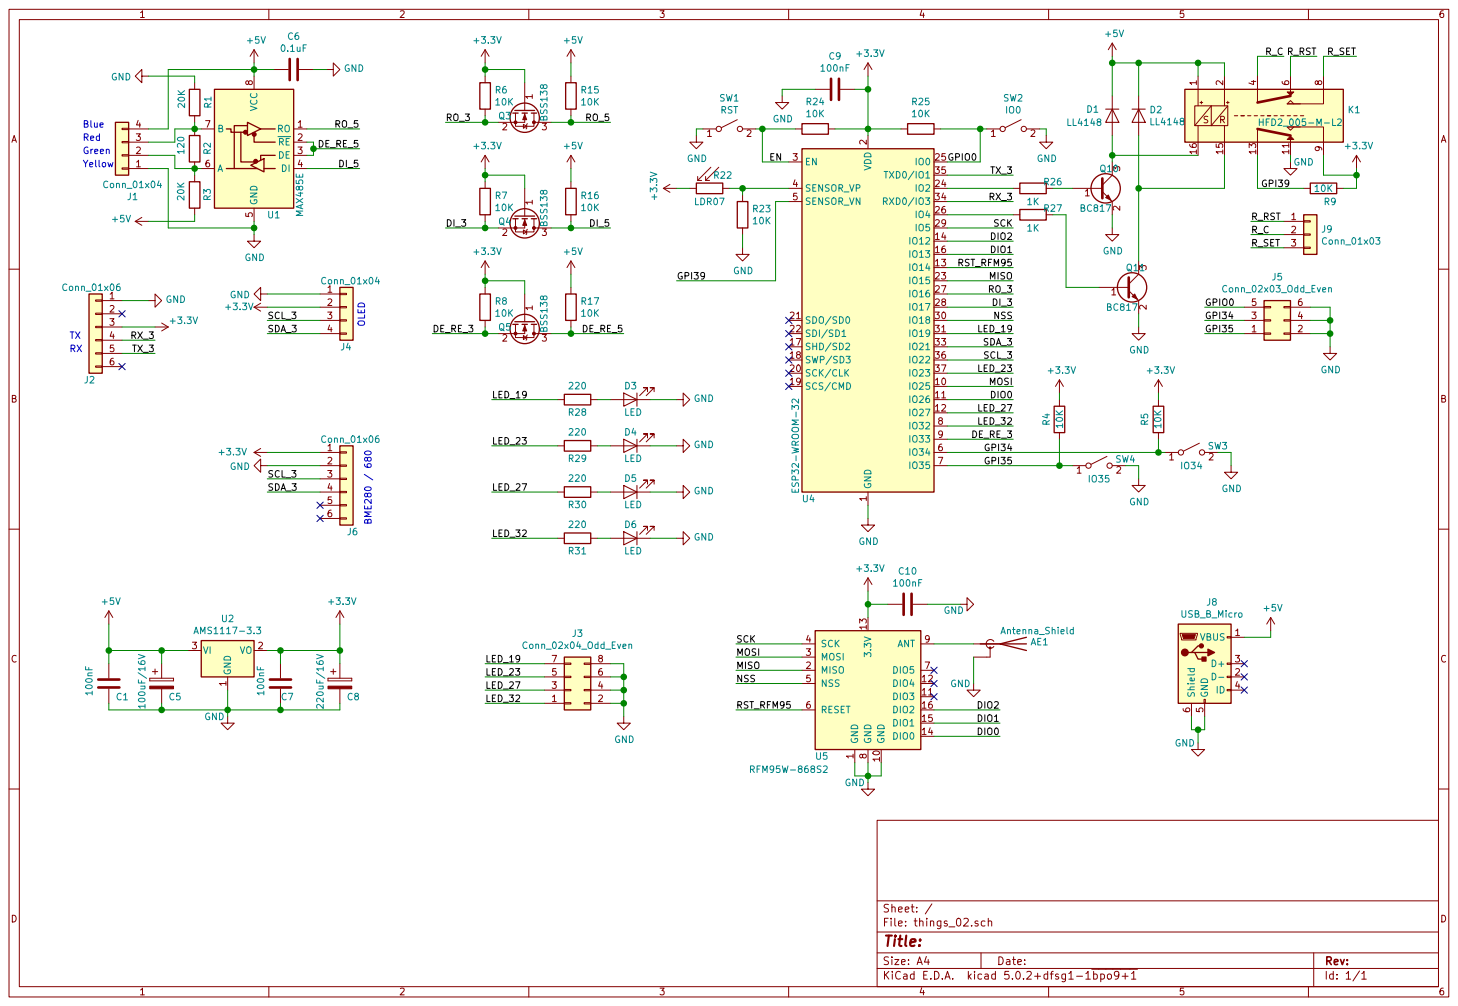
[picture p48: page 1]

2 SCK/CLK 20 SDO/SD0 21 SDI/SD1 22

8 ANT 9 U5 RFM95W-868S2 DIO0 MOSI NSS MISO

File: things_02.sch Sheet: / GND

1 GND 10 DIO3 11 DIO4 12 3.3V 13 DIO0 14 DIO1 15 DIO2 16 MISO 2 MOSI 3 SCK 4 NSS 5 RESET 6 DIO5 7 GND
