jordibinefa/IoT-02/board/pdf/things_02-F.SilkS.pdf

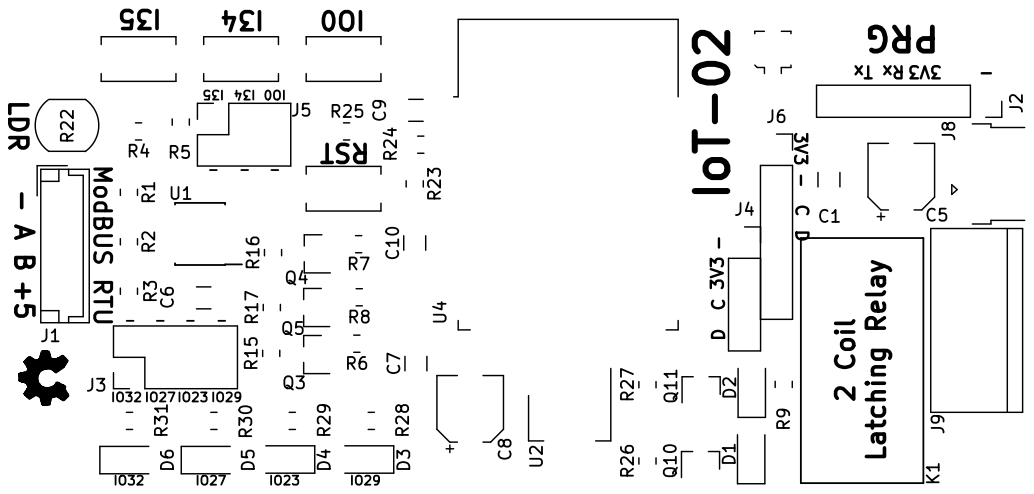
[picture p49: page 1]

2 Coil Latching Relay ModBUS RTU IoT-02I35 I34 IO0 RST
