jordibinefa/IoT-02/board/pdf/things_02-B.Cu.pdf

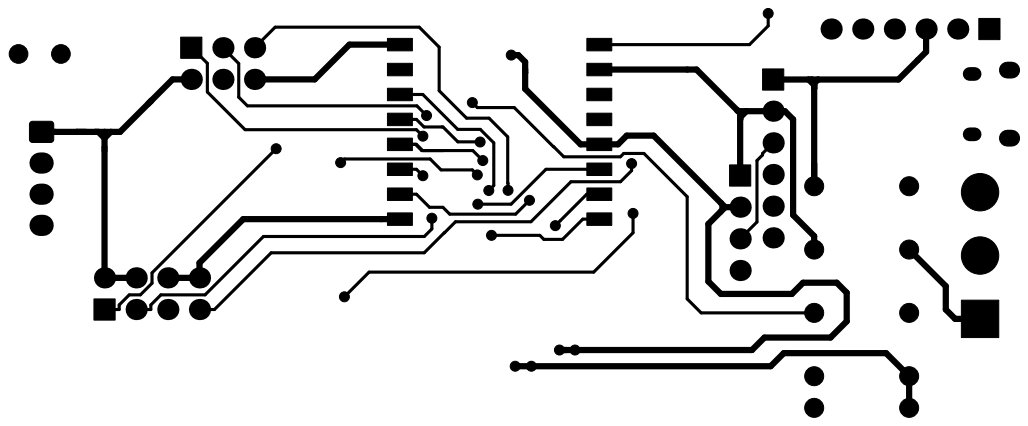
[picture p50: page 1]
