jordibinefa/IoT-02/board/pdf/things_02-B.Mask.pdf

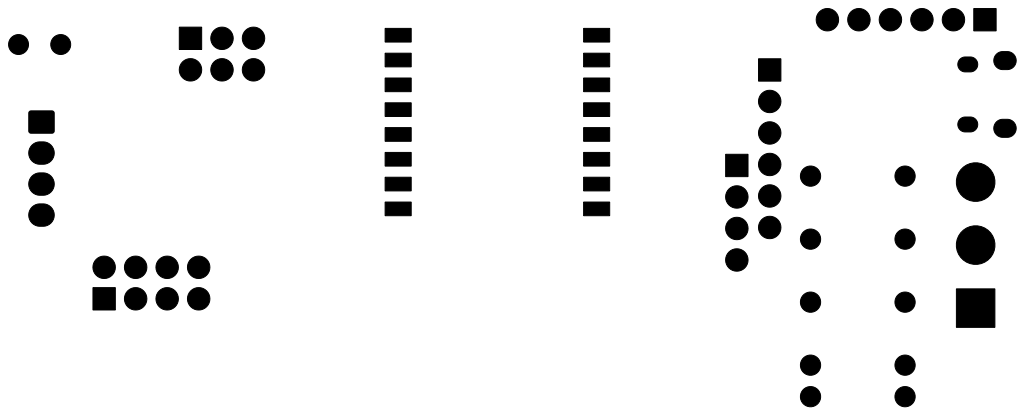
[picture p51: page 1]
