jordibinefa/IoT-02/board/pdf/things_02-B.SilkS.pdf

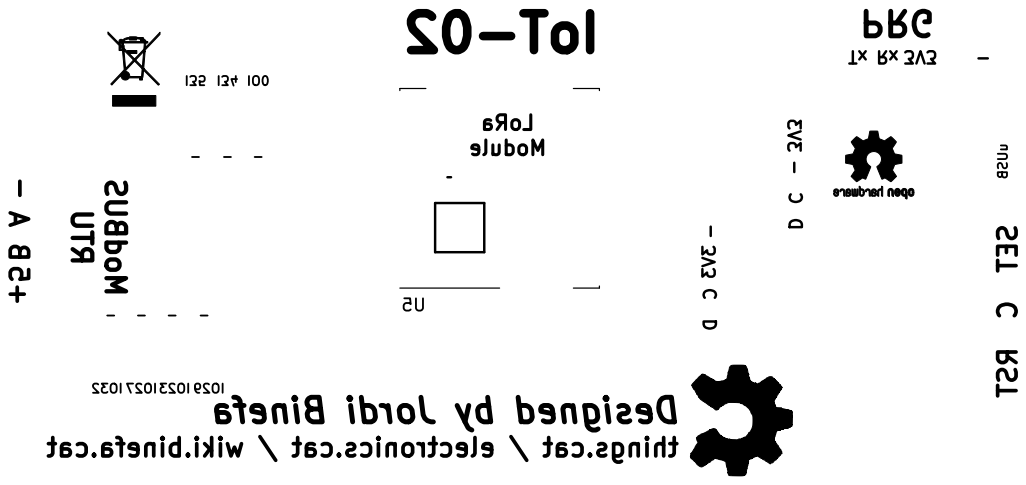
[picture p52: page 1]
