jordibinefa/IoT-02/board/pdf/things_02-Dwgs.User.pdf

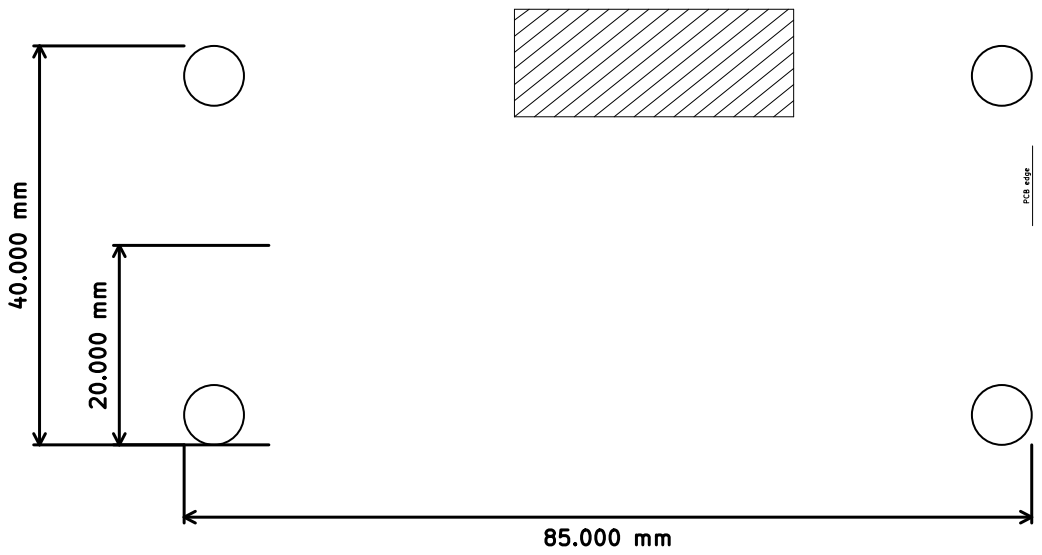
[picture p53: page 1]
