jordibinefa/IoT-02/board/pdf/things_02-Edge.Cuts.pdf

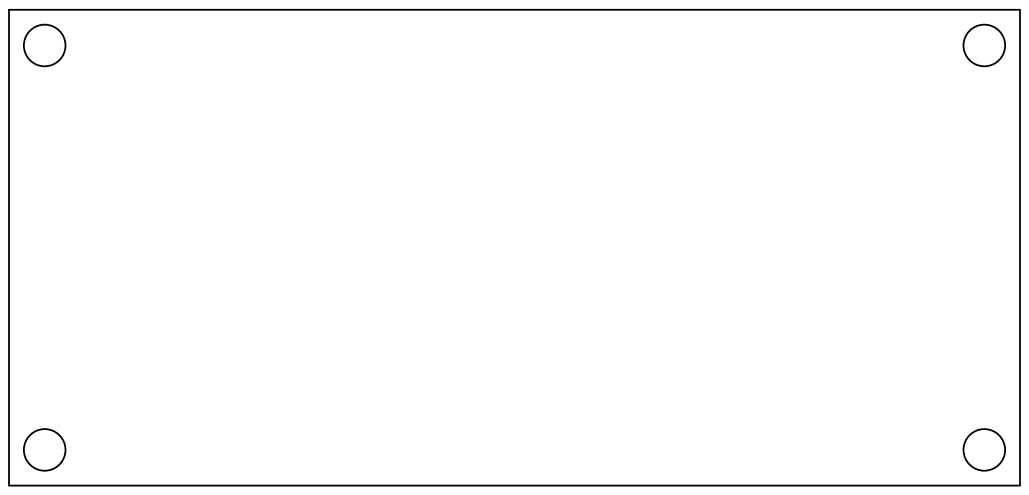
[picture p54: page 1]
