jordibinefa/IoT-02/board/pdf/things_02-F.Cu.pdf

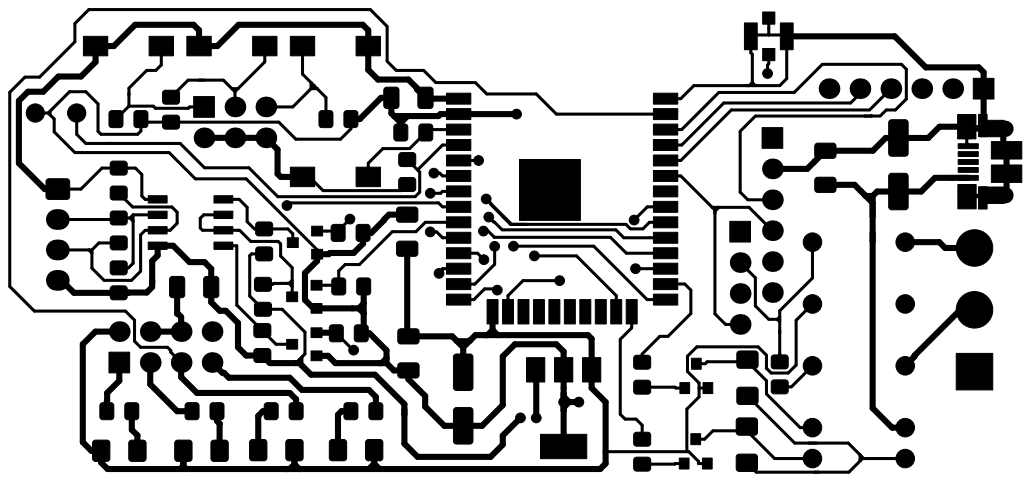
[picture p55: page 1]
