jordibinefa/IoT-02/board/pdf/things_02-F.Mask.pdf

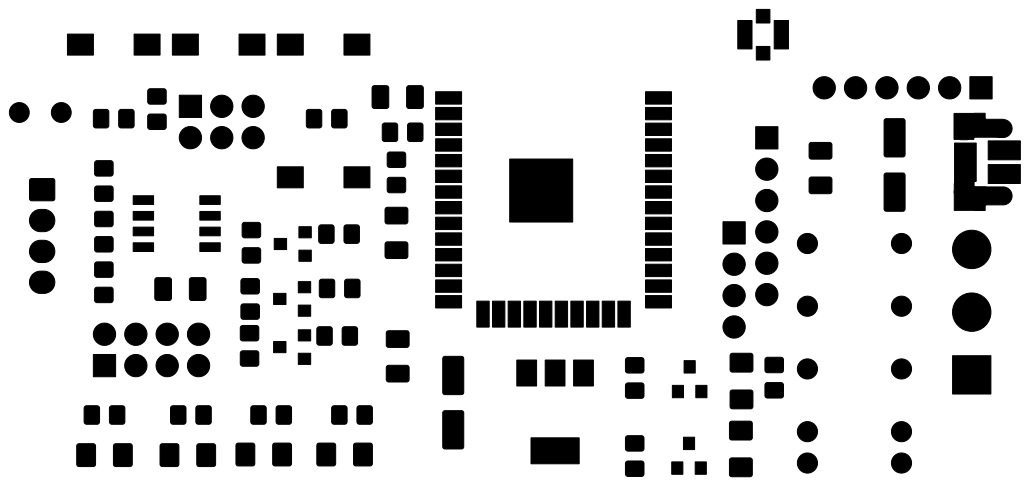
[picture p56: page 1]
