jordibinefa/IoT-02/board/pdf/things_02-F.Paste.pdf

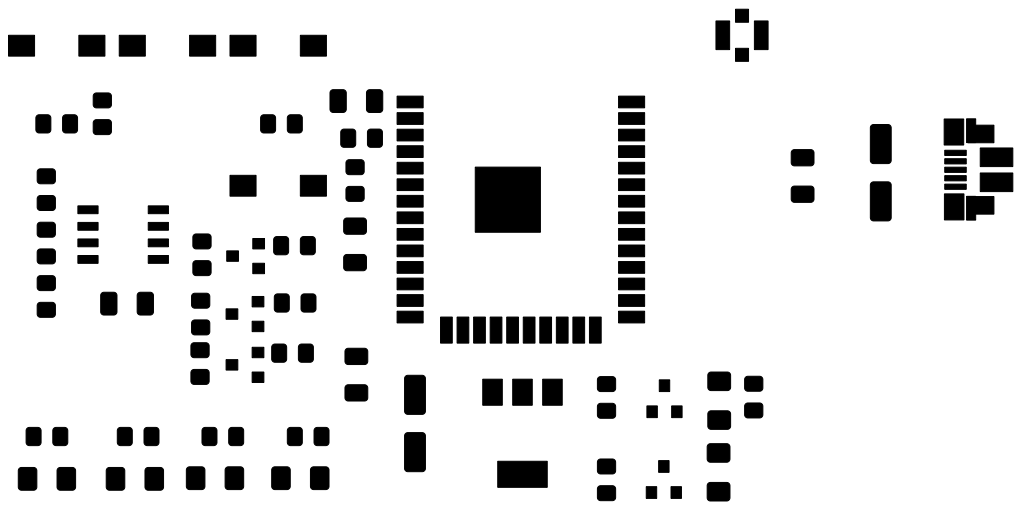
[picture p57: page 1]
