jordibinefa/IoT-02/(list of files, drawings)

Other design files:
board/kicad/things_02.dsn
