jordibinefa/IoT-02/board/kicad/things_02.kicad_pcb

## KiCad design board/kicad/things_02.kicad_pcb (2020-03-15)

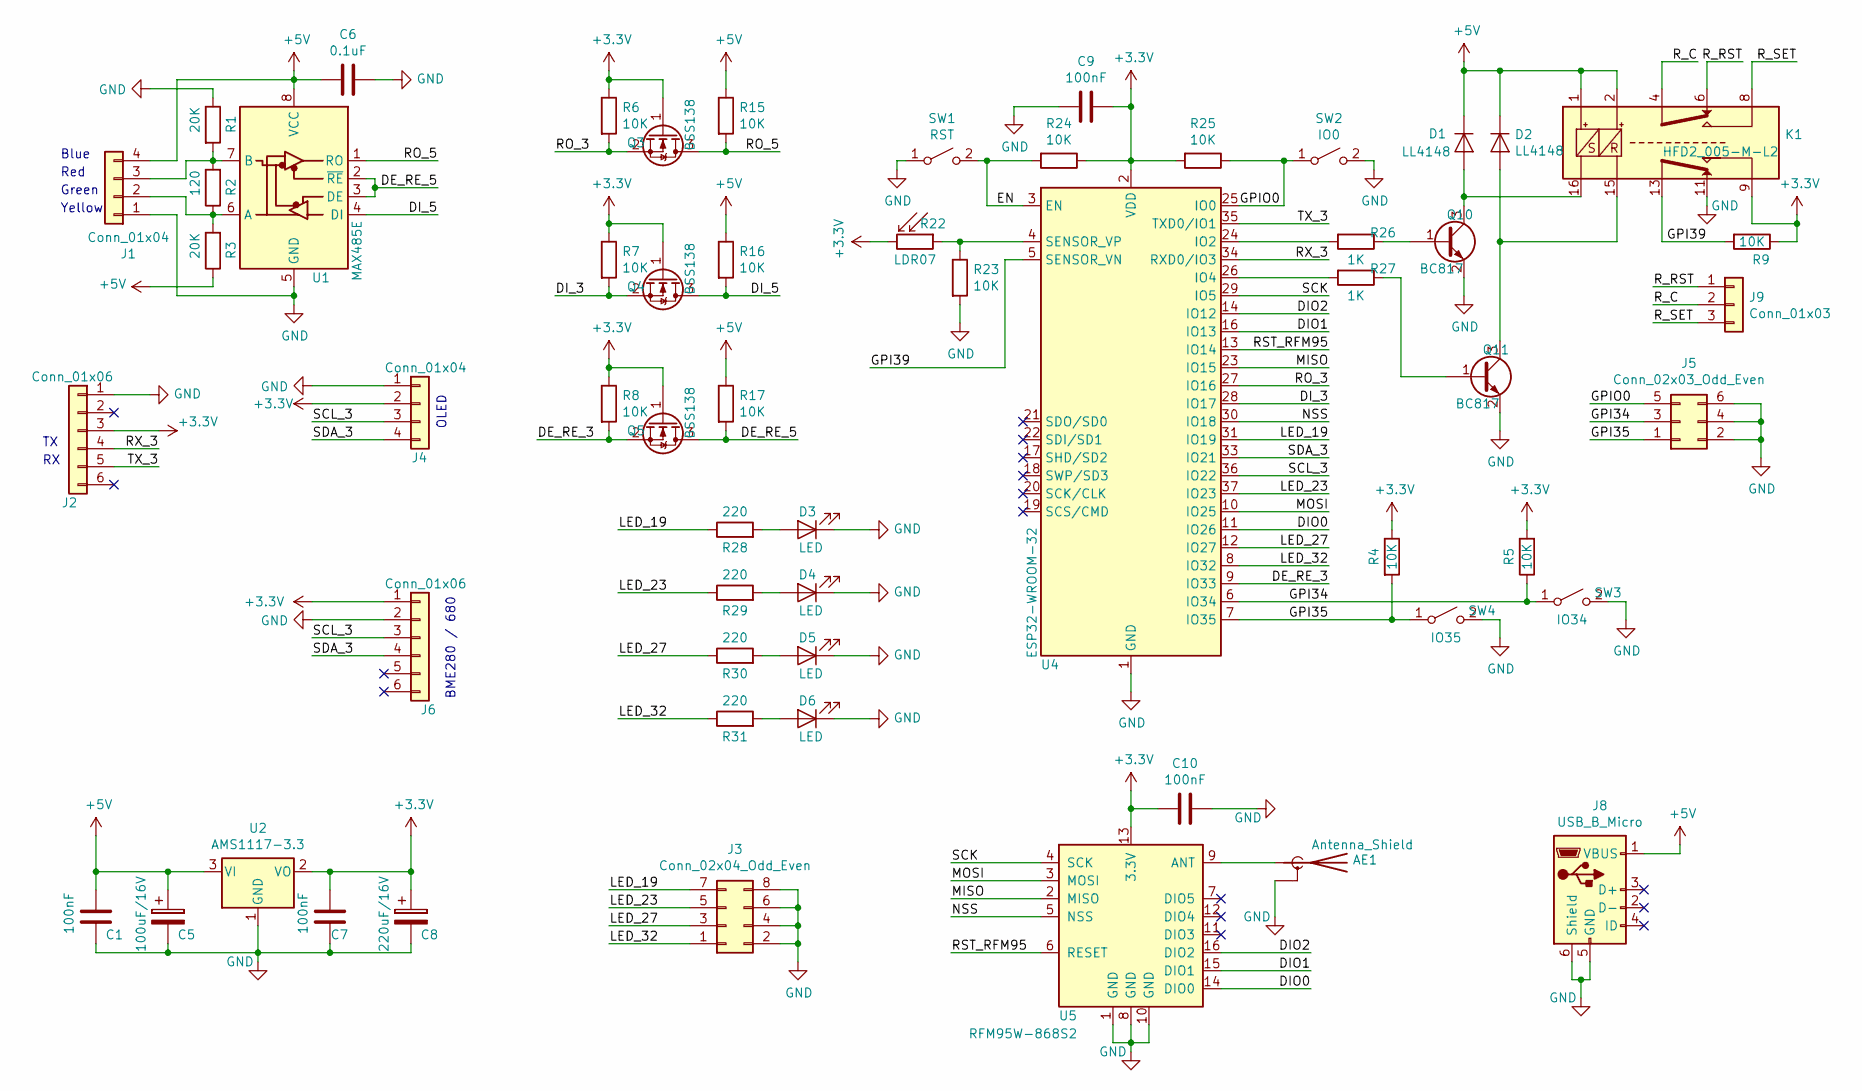
[picture p58: schematic things_02.sch]

Parts:
AE1: Antenna_Shield; U.FL_Molex_MCRF_73412-0110_Vertical
C1, C7, C9, C10: 100nF; C_1206_3216Metric
C5: 100uF/16V; CP_Elec_5x5.9
C6: 0.1uF; C_1206_3216Metric
C8: 220uF/16V; CP_Elec_5x5.9
D1, D2: LL4148; D_1206_3216Metric_Pad1.42x1.75mm_HandSolder
D3, D4, D5, D6: LED; LED_1206_3216Metric_Pad1.42x1.75mm_HandSolder
J1: Conn_01x04; JST_EH_B04B-EH-A_1x04_P2.50mm_Vertical
J2, J6: Conn_01x06; PinSocket_1x06_P2.54mm_Vertical
J3: Conn_02x04_Odd_Even; PinHeader_2x04_P2.54mm_Vertical
J4: Conn_01x04; PinSocket_1x04_P2.54mm_Vertical
J5: Conn_02x03_Odd_Even; PinSocket_2x03_P2.54mm_Vertical
J8: USB_B_Micro; USB_Micro-B_Amphenol_10103594-0001LF_Horizontal
J9: Conn_01x03; TerminalBlock_bornier-3_P5.08mm
K1: HFD2_005-M-L2
Q3, Q4, Q5: BSS138; SOT-23
Q10, Q11: BC817; SOT-23
R1, R3: 20K; R_0805_2012Metric_Pad1.15x1.40mm_HandSolder
R2: 120; R_0805_2012Metric_Pad1.15x1.40mm_HandSolder
R4, R5, R6, R7, R8, R9, R15, R16, R17, R23, R24, R25: 10K; R_0805_2012Metric_Pad1.15x1.40mm_HandSolder
R22: LDR07; R_LDR_5.1x4.3mm_P3.4mm_Vertical
R26, R27: 1K; R_0805_2012Metric_Pad1.15x1.40mm_HandSolder
R28, R29, R30, R31: 220; R_0805_2012Metric_Pad1.15x1.40mm_HandSolder
SW1: RST; SW_SPST_EVQPE1
SW2: IO0; SW_SPST_EVQPE1
SW3: IO34; SW_SPST_EVQPE1
SW4: IO35; SW_SPST_EVQPE1
U1: MAX485E; SOIC-8_3.9x4.9mm_P1.27mm
U2: AMS1117-3.3; SOT-223-3_TabPin2
U4: ESP32-WROOM-32
U5: RFM95W-868S2; HOPERF_RFM9XW_SMD

Connections:
+3V3: C7.1, C8.1, C9.1, C10.2, J2.3, J4.2, J6.1, K1.9, Q3.1 (G), Q4.1 (G), Q5.1 (G), R4.1, R5.2, R6.1, R7.1, R8.1, R9.1, R22.2, R24.1, R25.2, U2.2 (VO), U4.2 (VDD), U5.13 (3.3V)
+5V: C1.1, C5.1, C6.2, D1.1 (K), D2.1 (K), J1.4, J8.1 (VBUS), K1.1, K1.2, R3.1, R15.1, R16.1, R17.1, U1.8 (VCC), U2.3 (VI)
/DE_RE_3: Q5.2 (S), R8.2, U4.9 (IO33)
/DE_RE_5: Q5.3 (D), R17.2, U1.2 (~RE), U1.3 (DE)
/DIO0: U4.11 (IO26), U5.14 (DIO0)
/DIO1: U4.16 (IO13), U5.15 (DIO1)
/DIO2: U4.14 (IO12), U5.16 (DIO2)
/DI_3: Q4.2 (S), R7.2, U4.28 (IO17)
/DI_5: Q4.3 (D), R16.2, U1.4 (DI)
/EN: R24.2, SW1.2 (B), U4.3 (EN)
/GPI34: J5.3, R5.1, SW3.1 (A), U4.6 (IO34)
/GPI35: J5.1, R4.2, SW4.1 (A), U4.7 (IO35)
/GPI39: K1.13, R9.2, U4.5 (SENSOR_VN)
/GPIO0: J5.5, R25.1, SW2.1 (A), U4.25 (IO0)
/LED_19: J3.7, R28.1, U4.31 (IO19)
/LED_23: J3.5, R29.1, U4.37 (IO23)
/LED_27: J3.3, R30.1, U4.12 (IO27)
/LED_32: J3.1, R31.1, U4.8 (IO32)
/MISO: U4.23 (IO15), U5.2 (MISO)
/MOSI: U4.10 (IO25), U5.3 (MOSI)
/NSS: U4.30 (IO18), U5.5 (NSS)
/RO_3: Q3.2 (S), R6.2, U4.27 (IO16)
/RO_5: Q3.3 (D), R15.2, U1.1 (RO)
/RST_RFM95: U4.13 (IO14), U5.6 (RESET)
/RX_3: J2.4, U4.34 (RXD0/IO3)
/R_C: J9.2, K1.4
/R_RST: J9.1, K1.6
/R_SET: J9.3, K1.8
/SCK: U4.29 (IO5), U5.4 (SCK)
/SCL_3: J4.3, J6.3, U4.36 (IO22)
/SDA_3: J4.4, J6.4, U4.33 (IO21)
/TX_3: J2.5, U4.35 (TXD0/IO1)
GND: AE1.2 (Shield), C1.2, C5.2, C6.1, C7.2, C8.2, C9.2, C10.1, D3.1 (K), D4.1 (K), D5.1 (K), D6.1 (K), J1.1, J2.1, J3.2, J3.4, J3.6, J3.8, J4.1, J5.2, J5.4, J5.6, J6.2, J8.5 (GND), J8.6 (Shield), K1.11, Q10.2 (E), Q11.2 (E), R1.1, R23.2, SW1.1 (A), SW2.2 (B), SW3.2 (B), SW4.2 (B), U1.5 (GND), U2.1 (GND), U4.1 (GND), U4.15 (GND), U4.38 (GND), U5.1 (GND), U5.8 (GND), U5.10 (GND)
unnamed: AE1.1 (A), U5.9 (ANT)
unnamed: D1.2 (A), K1.16, Q10.3 (C)
unnamed: D2.2 (A), K1.15, Q11.3 (C)
unnamed: D3.2 (A), R28.2
unnamed: D4.2 (A), R29.2
unnamed: D5.2 (A), R30.2
unnamed: D6.2 (A), R31.2
unnamed: J1.2, R2.1, R3.2, U1.6 (A)
unnamed: J1.3, R1.2, R2.2, U1.7 (B)
unnamed: Q10.1 (B), R26.1
unnamed: Q11.1 (B), R27.1
unnamed: R22.1, R23.1, U4.4 (SENSOR_VP)
unnamed: R26.2, U4.24 (IO2)
unnamed: R27.2, U4.26 (IO4)

Notes on the sheet:
Blue
Red
Green
Yellow
OLED
BME280 / 680

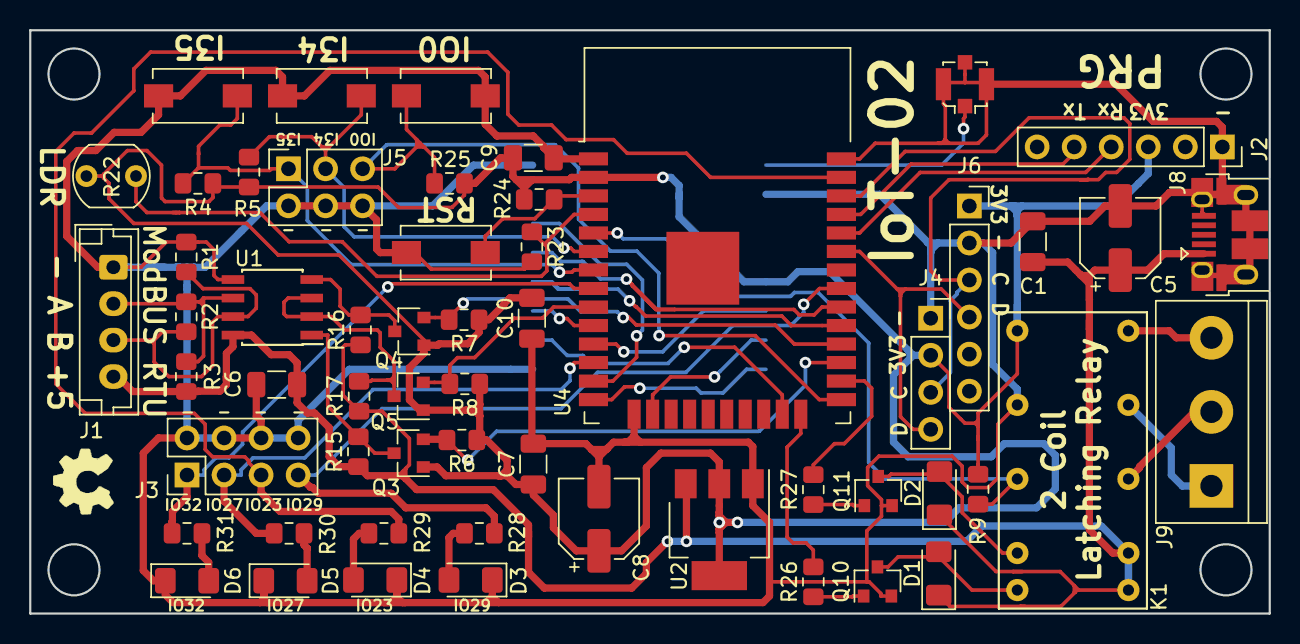
[picture p59: board things_02.kicad_pcb from above]

Board: 2 copper layers, 85.0 x 40.0 mm, 58 parts (1 on the bottom side), 47 nets.
