jordibinefa/IoT-02/codes/IoT-02_11_modbus_bme280_02/IoT-02_pinout.h

#ifndef IOT_02_PINOUT_H
#define IOT_02_PINOUT_H

#define LED_W 19
#define LED_R 23
#define LED_Y 27
#define LED_G 32
#define SET_LATCHING_RELAY 2
#define RST_LATCHING_RELAY 4
#define BT_IO0 0
#define BT_I34 34
#define BT_I35 35
#define STATE_LATCHING_RELAY 39
#define LDR 36
#define I2C_SDA 21
#define I2C_SCL 22

#define TX_MODBUS 17
#define RX_MODBUS 16
#define SSerialTxControl 33 /*RS485 Direction control*/

#endif
