jordibinefa/IoT-02/codes/IoT-02_IMU_Classify_by_led/Classifier.h

#ifndef UUID140663061376080
#define UUID140663061376080

/**
  * RandomForestClassifier(base_estimator=deprecated, bootstrap=True, ccp_alpha=0.0, class_name=RandomForestClassifier, class_weight=None, criterion=gini, estimator=DecisionTreeClassifier(), estimator_params=('criterion', 'max_depth', 'min_samples_split', 'min_samples_leaf', 'min_weight_fraction_leaf', 'max_features', 'max_leaf_nodes', 'min_impurity_decrease', 'random_state', 'ccp_alpha'), max_depth=20, max_features=sqrt, max_leaf_nodes=None, max_samples=None, min_impurity_decrease=0.0, min_samples_leaf=1, min_samples_split=2, min_weight_fraction_leaf=0.0, n_estimators=20, n_jobs=None, num_outputs=4, oob_score=False, package_name=everywhereml.sklearn.ensemble, random_state=None, template_folder=everywhereml/sklearn/ensemble, verbose=0, warm_start=False)
 */
class RandomForestClassifier {
    public:

        /**
         * Predict class from features
         */
        int predict(float *x) {
            int predictedValue = 0;
            size_t startedAt = micros();

            
                    
            uint16_t votes[4] = { 0 };
            uint8_t classIdx = 0;
            float classScore = 0;

            
                tree0(x, &classIdx, &classScore);
                votes[classIdx] += classScore;
            
                tree1(x, &classIdx, &classScore);
                votes[classIdx] += classScore;
            
                tree2(x, &classIdx, &classScore);
                votes[classIdx] += classScore;
            
                tree3(x, &classIdx, &classScore);
                votes[classIdx] += classScore;
            
                tree4(x, &classIdx, &classScore);
                votes[classIdx] += classScore;
            
                tree5(x, &classIdx, &classScore);
                votes[classIdx] += classScore;
            
                tree6(x, &classIdx, &classScore);
                votes[classIdx] += classScore;
            
                tree7(x, &classIdx, &classScore);
                votes[classIdx] += classScore;
            
                tree8(x, &classIdx, &classScore);
                votes[classIdx] += classScore;
            
                tree9(x, &classIdx, &classScore);
                votes[classIdx] += classScore;
            
                tree10(x, &classIdx, &classScore);
                votes[classIdx] += classScore;
            
                tree11(x, &classIdx, &classScore);
                votes[classIdx] += classScore;
            
                tree12(x, &classIdx, &classScore);
                votes[classIdx] += classScore;
            
                tree13(x, &classIdx, &classScore);
                votes[classIdx] += classScore;
            
                tree14(x, &classIdx, &classScore);
                votes[classIdx] += classScore;
            
                tree15(x, &classIdx, &classScore);
                votes[classIdx] += classScore;
            
                tree16(x, &classIdx, &classScore);
                votes[classIdx] += classScore;
            
                tree17(x, &classIdx, &classScore);
                votes[classIdx] += classScore;
            
                tree18(x, &classIdx, &classScore);
                votes[classIdx] += classScore;
            
                tree19(x, &classIdx, &classScore);
                votes[classIdx] += classScore;
            

            // return argmax of votes
            uint8_t maxClassIdx = 0;
            float maxVote = votes[0];

            for (uint8_t i = 1; i < 4; i++) {
                if (votes[i] > maxVote) {
                    maxClassIdx = i;
                    maxVote = votes[i];
                }
            }

            predictedValue = maxClassIdx;

                    

            latency = micros() - startedAt;

            return (lastPrediction = predictedValue);
        }

        
            

            /**
             * Predict class label
             */
            String predictLabel(float *x) {
                return getLabelOf(predict(x));
            }

            /**
             * Get label of last prediction
             */
            String getLabel() {
                return getLabelOf(lastPrediction);
            }

            /**
             * Get label of given class
             */
            String getLabelOf(int8_t idx) {
                switch (idx) {
                    case -1:
                        return "ERROR";
                    
                        case 0:
                            return "quiet";
                    
                        case 1:
                            return "amunt-avall";
                    
                        case 2:
                            return "esquerra-dreta";
                    
                        case 3:
                            return "cercle";
                    
                    default:
                        return "UNKNOWN";
                }
            }


            /**
             * Get latency in micros
             */
            uint32_t latencyInMicros() {
                return latency;
            }

            /**
             * Get latency in millis
             */
            uint16_t latencyInMillis() {
                return latency / 1000;
            }
            

    protected:
        float latency = 0;
        int lastPrediction = 0;

        
            

        
            
                /**
                 * Random forest's tree #0
                 */
                void tree0(float *x, uint8_t *classIdx, float *classScore) {
                    
                        if (x[28] < 0.03583278600126505) {
                            
                                
                        *classIdx = 0;
                        *classScore = 74.0;
                        return;

                            
                        }
                        else {
                            
                                
                        if (x[48] < 0.08397645130753517) {
                            
                                
                        if (x[28] < 0.09337219968438148) {
                            
                                
                        if (x[102] < 0.8369963467121124) {
                            
                                
                        if (x[18] < 0.826737642288208) {
                            
                                
                        *classIdx = 1;
                        *classScore = 72.0;
                        return;

                            
                        }
                        else {
                            
                                
                        *classIdx = 2;
                        *classScore = 61.0;
                        return;

                            
                        }

                            
                        }
                        else {
                            
                                
                        *classIdx = 3;
                        *classScore = 68.0;
                        return;

                            
                        }

                            
                        }
                        else {
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

                            
                        }

                            
                        }

                            
                        }

                }
            
        


            
};



static RandomForestClassifier forest;


#endif
