jordibinefa/IoT-02/micropython/prj_mp_modbus_master_00/main.py

'''
Based on: https://github.com/eydam-prototyping/mp_modbus

https://github.com/jordibinefa/IoT-02/tree/master/micropython/prj_mp_modbus_master_00

20220830
'''
import utime
utime.sleep(4)
# import range
import mp_modbus_master_tester
