jordibinefa/IoT-02/codes/IoT-02_mqtt_sync_upcSchool_broker1/IoT-02_wifiCredentials.h

#ifndef IOT_02_WIFI_CREDENTIALS_H
#define IOT_02_WIFI_CREDENTIALS_H

#define N_WIFIS 9
#define MAX_STRING_SIZE 15

struct stWifiList {
  const char* szSSID;
  const char* szPWD;
};

/*struct*/ stWifiList stWiFi[N_WIFIS] = {
  {"MiFibra-213B" , "JdkZYbkx"},
  {"IoT-eCat_RPi" , "clotClot"},
  {"WIFI_SIARQ","GuestsWLAN@Siarq"},
  {"VodafoneMobileWiFi-6D9883","7770797201"},
  {"IoT-eCat" , "clotClot"},
  {"ONO1BD3","YeneA9pwQx81"},
  {"CASTELLA40_2G","1A2B3C4D5E"},
  {"JE_DAW_DAM_2" , "clotClot"},
  {"iotcat" , "1234567890a"}
};

#endif // IOT_02_WIFI_CREDENTIALS_H
