jordibinefa/IoT-02/codes/IoT-02_11_modbus_bme280_02/IoT-02_modbus.h

#include "Arduino.h"

#ifndef IOT_02_MODBUS_H
#define IOT_02_MODBUS_H

#include "IoT-02_pinout.h"
#include <driver/uart.h>

#define MODULE_ADDRESS 0x07
#define COIL_RELAY_ADDRESS 0x0004
#define COIL_INPUTS_ADDRESS 0x0000
#define HOLDING_REGISTER_TEMEPRATURE_ADDRESS 0x0000
#define HOLDING_REGISTER_REL_HUMIDITY_ADDRESS 0x0001
#define HOLDING_REGISTER_PRESSURE_ADDRESS 0x0002
#define HOLDING_REGISTER_ALTITUDE_ADDRESS 0x0003
#define HOLDING_REGISTER_VOC_ADDRESS 0x0004

#define MODBUS_UART_PORT UART_NUM_2
#define BUF_SIZE 127
#define PACKET_READ_TICS        (100 / portTICK_RATE_MS)
#define N_MAX 99

void vSetupModBus(int nBauds);
void vWriteCoil(byte* ucSt, int len);
void vReadInputs(byte* ucSt, int len);
void vReadHoldingRegisters(byte* ucSt, int len);
void vProcessa(byte* ucSt, int len);
void vModBusReading();

byte byReadInputs();
unsigned int uiModRTU_CRC(byte *buf, int len);

#endif
