jordibinefa/IoT-02/codes/IoT-02_06_i2cScanner/IoT-02_06_i2cScanner.ino

// https://github.com/jordibinefa/IoT-02/tree/master/codes
// things.cat
//
// Code written by Jordi Binefa. 20200405
// Based on: https://playground.arduino.cc/Main/I2cScanner?action=sourceblock&num=1

#include <Wire.h>
#include "IoT-02_pinout.h"
#include "IoT-02_common.h"

void setup() {
  Wire.begin(I2C_SDA, I2C_SCL);
  vSetupIO();
  Serial.begin(115200);
  Serial.println(__FILE__);
}

void loop() {
  byte error, address;
  int nDevices;

  Serial.println("Scanning I2C devices attached at IoT-02 board...");

  nDevices = 0;
  for (address = 1; address < 127; address++ )  {
    // The i2c_scanner uses the return value of
    // the Write.endTransmisstion to see if
    // a device did acknowledge to the address.
    Wire.beginTransmission(address);
    error = Wire.endTransmission();

    if (error == 0) {
      Serial.print("I2C device found at address 0x");
      if (address < 16)
        Serial.print("0");
      Serial.print(address, HEX);
      Serial.println("  !");

      nDevices++;
    }
    else if (error == 4)    {
      Serial.print("Unknown error at address 0x");
      if (address < 16)
        Serial.print("0");
      Serial.println(address, HEX);
    }
  }
  if (nDevices == 0)
    Serial.println("No I2C devices found\n");
  else
    Serial.println("done\n");

  delay(5000);           // wait 5 seconds for next scan
}
