jordibinefa/IoT-02/(commit log)

2024-07-05 Update IoT-02_wifiMng.cpp
    Migrating from ESP32 compiler v2 to v3
2024-07-05 Update IoT-02_wifiMng.cpp
    To be able to compile this code using new ESP32 compiler v3
2024-07-05 Update IoT-02_wifiMng.cpp
    To be able to compile using ESP32 compiler v3
